emiljaregran/mecanum-wheel-rover/README.md

# mecanum-wheel-rover
A mecanum wheel rover built during a 2 week project.

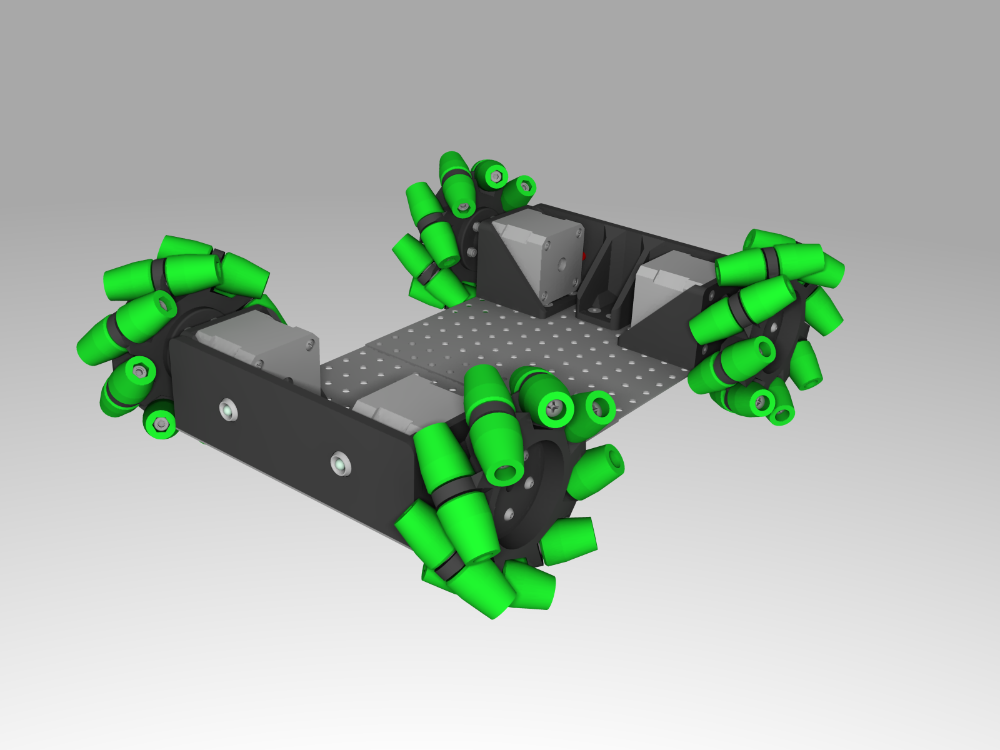
[picture p1: images/rover-front.png]
Rover front


The wheels are a remix of https://www.thingiverse.com/thing:2473
