emiljaregran/mecanum-wheel-rover/images/joystick-inside.png

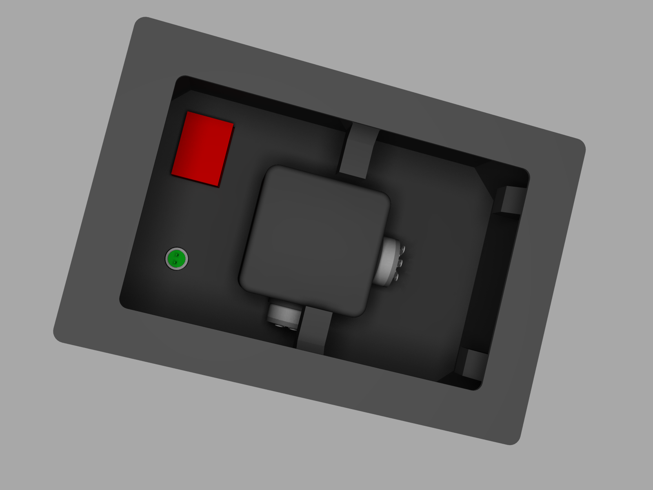
images/joystick-inside.png
