emiljaregran/mecanum-wheel-rover/images/joystick-pcb.png

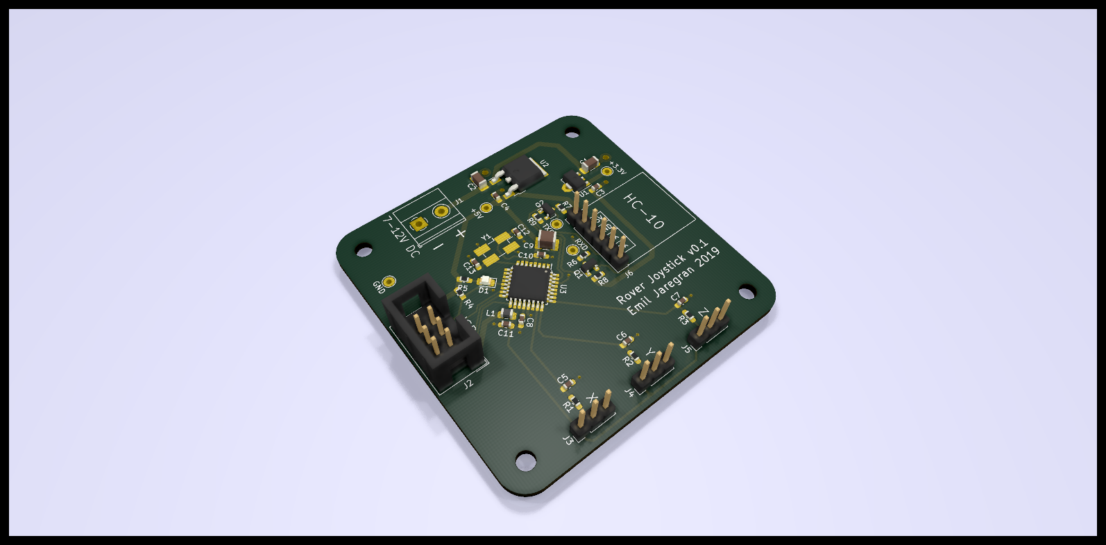
images/joystick-pcb.png
