emiljaregran/mecanum-wheel-rover/images/joystick.png

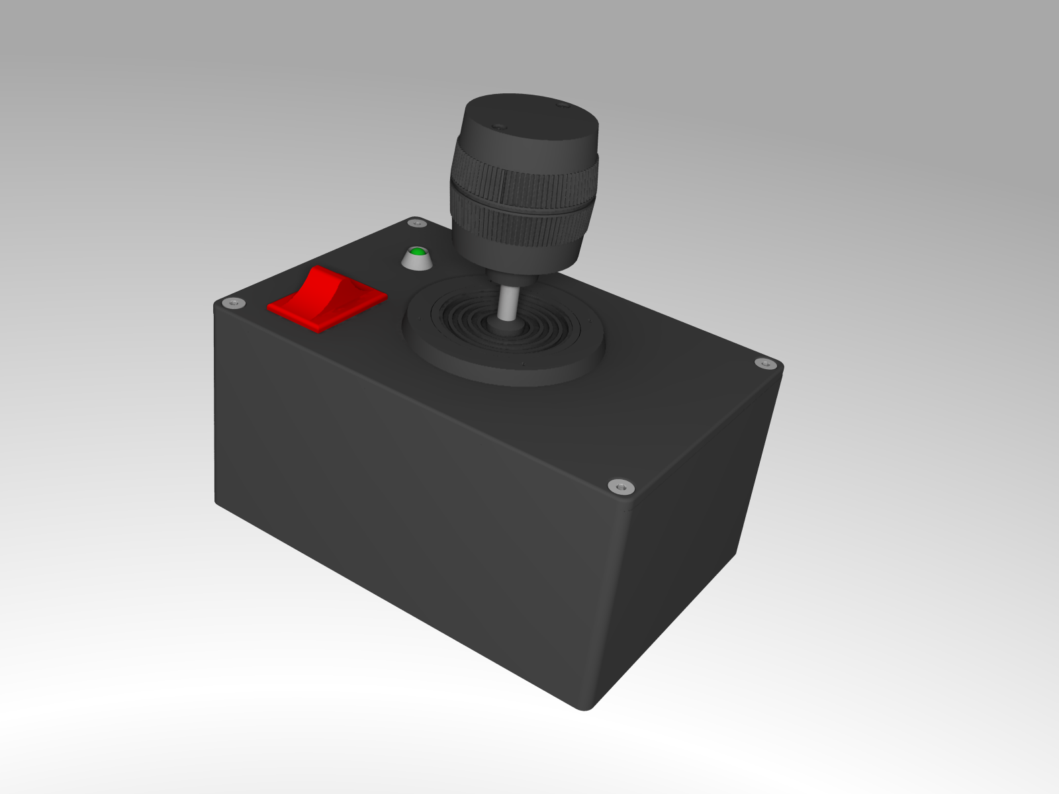
images/joystick.png
