emiljaregran/mecanum-wheel-rover/images/rover-side.png

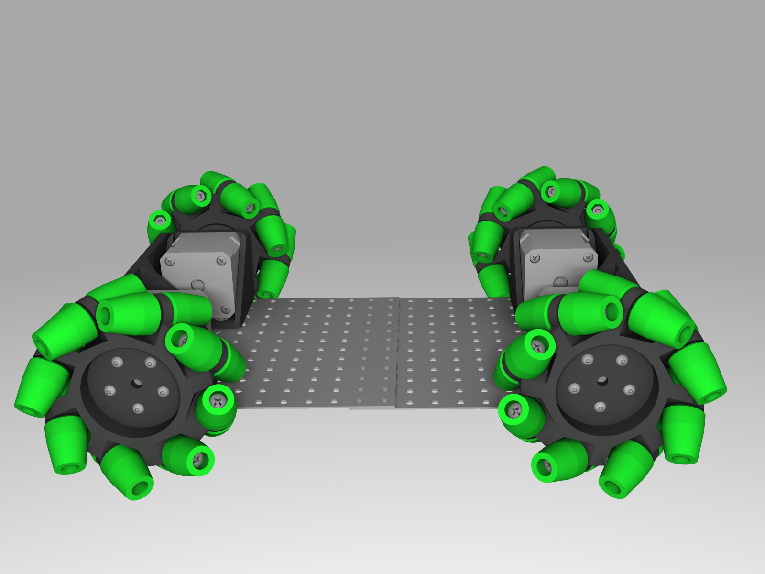
images/rover-side.png
