emiljaregran/mecanum-wheel-rover/joystick-parts/joystick_assembly.FCStd

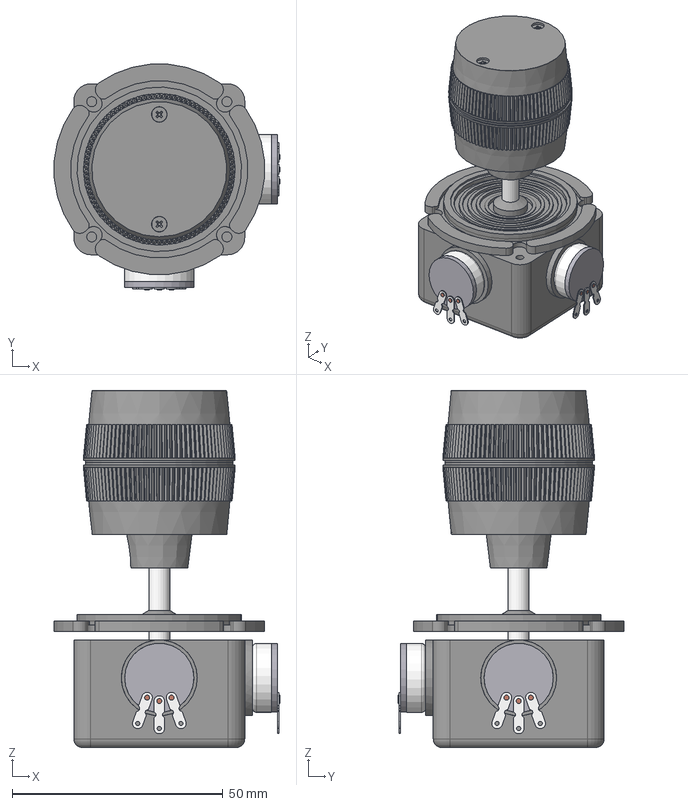
[picture p6: CAD file, 2019-10-08]
joystick-parts/joystick_assembly.FCStd
53.5 x 53.5 x 84.6 mm
joystick_base_001
joystick_shaft_001
pot_mid_001
pot_mid_002
pot_back_001
pot_back_002
pot_tab_001
pot_tab_002
pot_tab_003
pot_tab_004
pot_tab_005
pot_tab_006
pot_tab_rivet_001
pot_tab_rivet_002
pot_tab_rivet_003
pot_tab_rivet_004
pot_tab_rivet_005
pot_tab_rivet_006
joystick_knob_lower_001
joystick_knob_001
joystick_knob_002
joystick_shaft_boot_001
