emiljaregran/mecanum-wheel-rover/joystick-parts/joystick_knob_top.FCStd

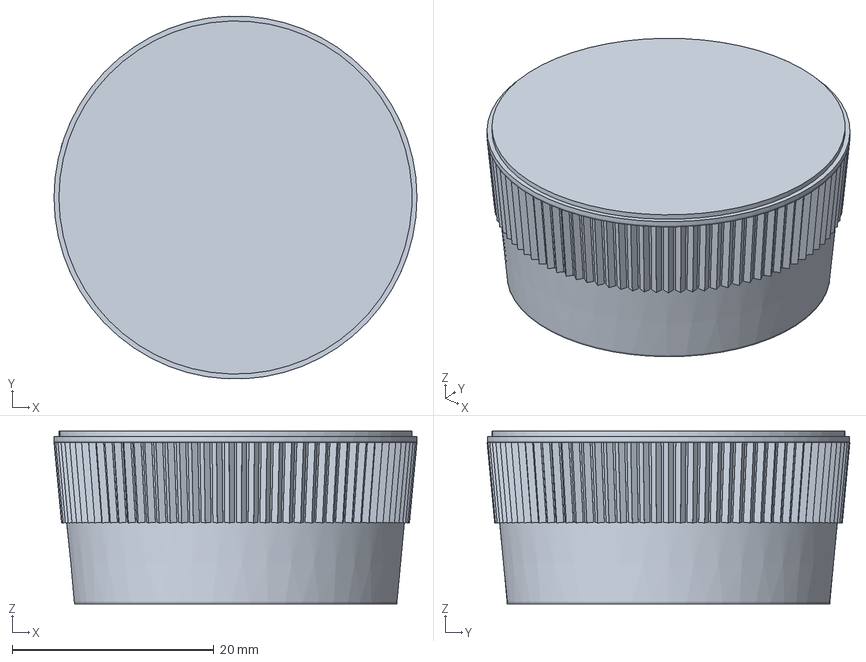
[picture p7: CAD file, 2019-10-08]
joystick-parts/joystick_knob_top.FCStd
36.0 x 36.0 x 17.1 mm
M2x4_Screw
M2x4_Screw001
