emiljaregran/mecanum-wheel-rover/rover-parts/fan_mount.FCStd

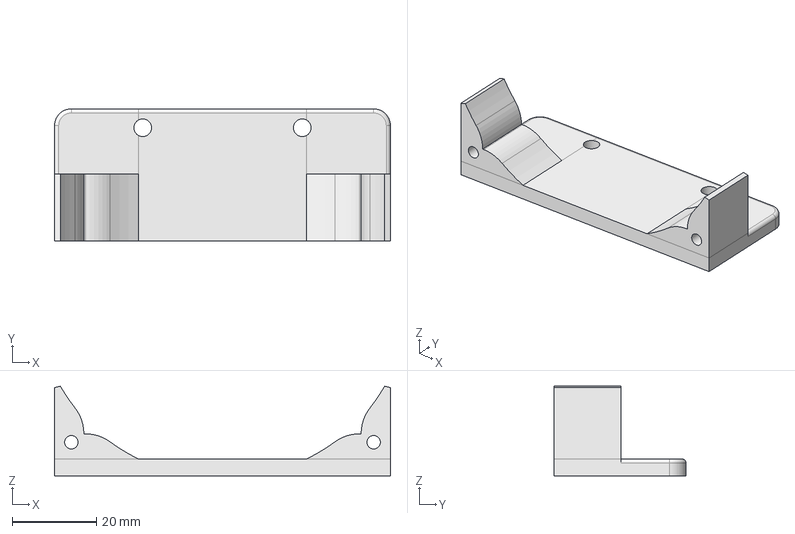
[picture p8: CAD file, 2019-10-12]
rover-parts/fan_mount.FCStd
80.0 x 31.5 x 21.3 mm
