emiljaregran/mecanum-wheel-rover/joystick-parts/pot_tab_rivet.FCStd

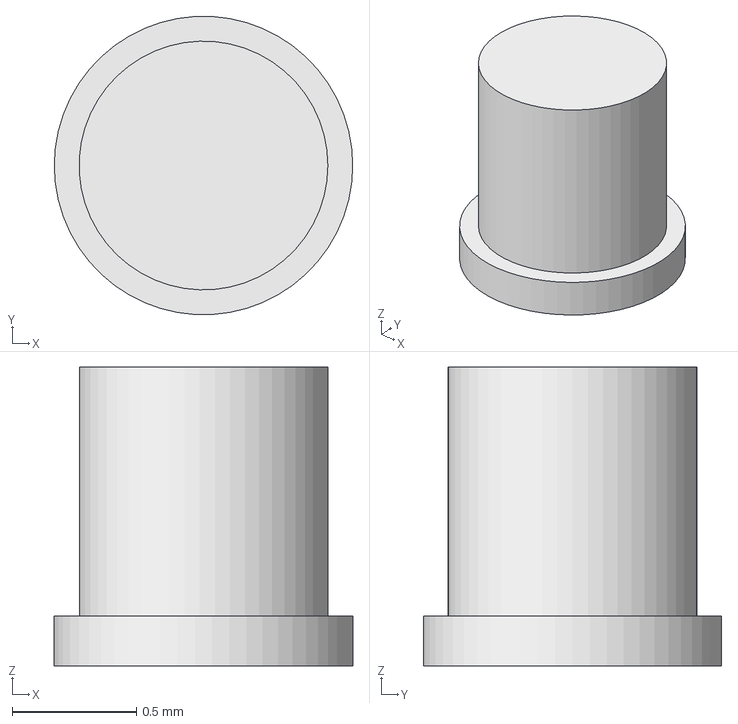
[picture p9: CAD file, 2019-10-08]
joystick-parts/pot_tab_rivet.FCStd
1.20 x 1.20 x 1.20 mm
