emiljaregran/mecanum-wheel-rover/rover-parts/stepper_motor_mount.FCStd

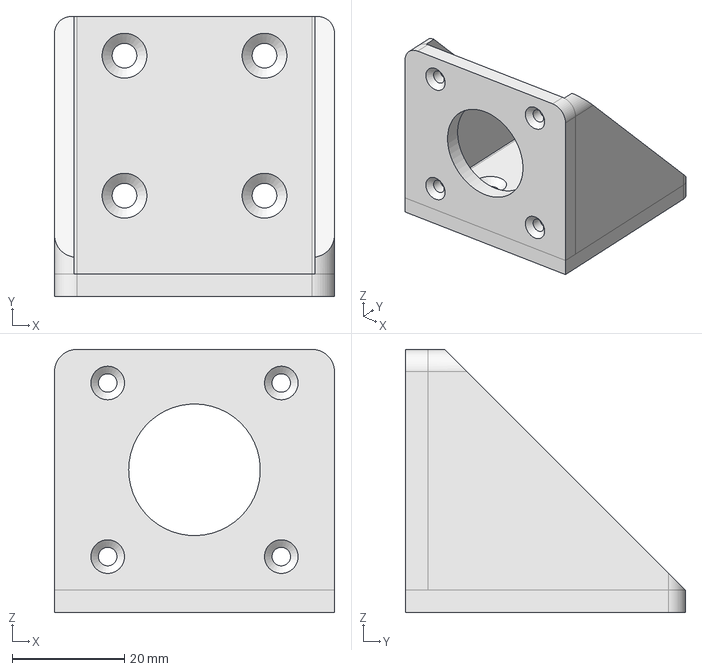
[picture p10: CAD file, 2019-10-08]
rover-parts/stepper_motor_mount.FCStd
50.0 x 50.0 x 47.0 mm
