emiljaregran/mecanum-wheel-rover/joystick-parts/pot_mid.FCStd

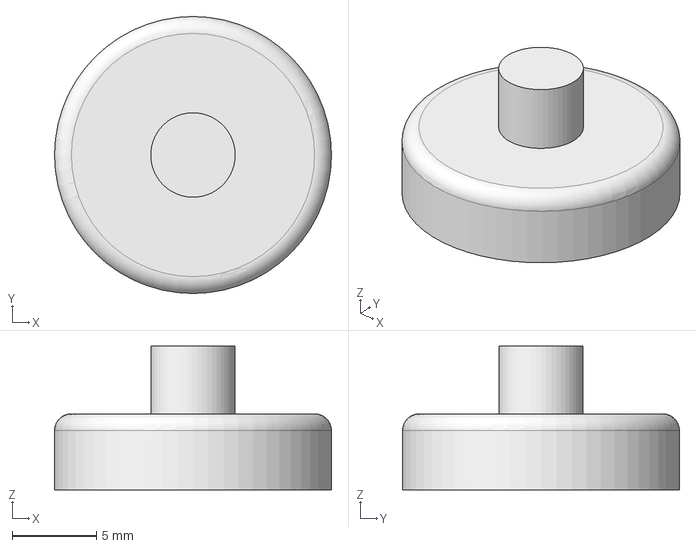
[picture p11: CAD file, 2019-10-08]
joystick-parts/pot_mid.FCStd
16.4 x 16.4 x 8.50 mm
