emiljaregran/mecanum-wheel-rover/rover-parts/stepper_motor.FCStd

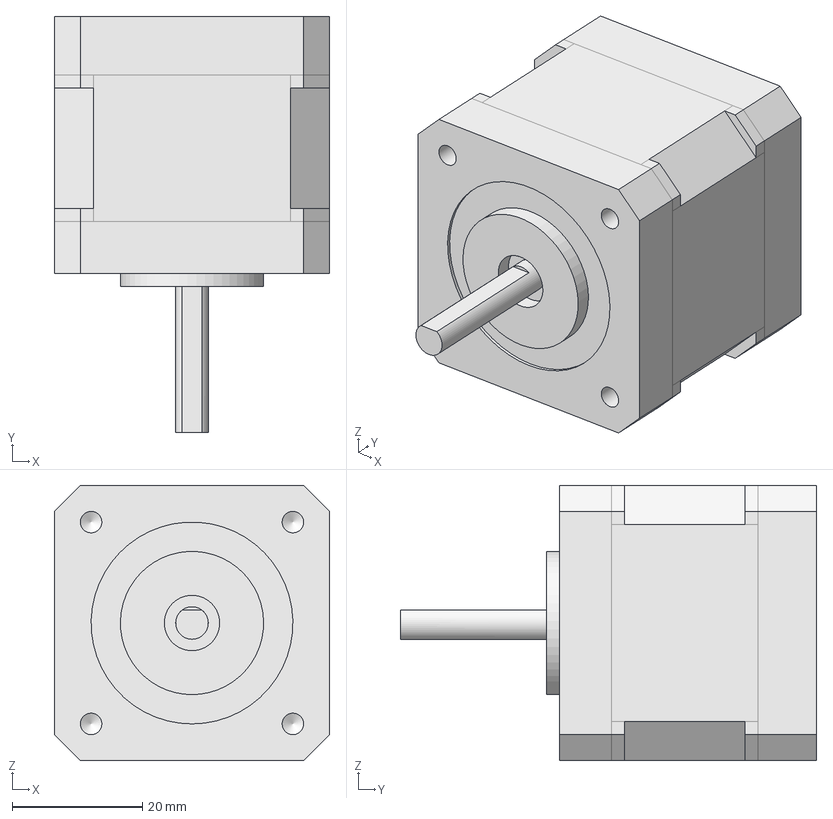
[picture p12: CAD file, 2019-10-08]
rover-parts/stepper_motor.FCStd
42.3 x 63.9 x 42.3 mm
M3x8_Screw_000
M3x8_Screw_001
M3x8_Screw_002
M3x8_Screw_003
