emiljaregran/mecanum-wheel-rover/joystick-parts/box_lid.FCStd

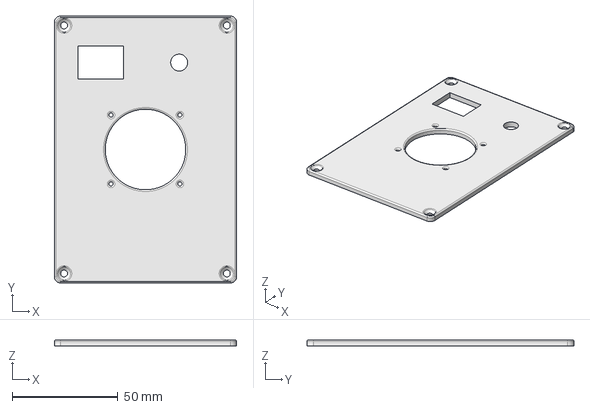
[picture p13: CAD file, 2019-10-08]
joystick-parts/box_lid.FCStd
86.0 x 126.0 x 3.00 mm
