emiljaregran/mecanum-wheel-rover/joystick-parts/joystick_knob_lower.FCStd

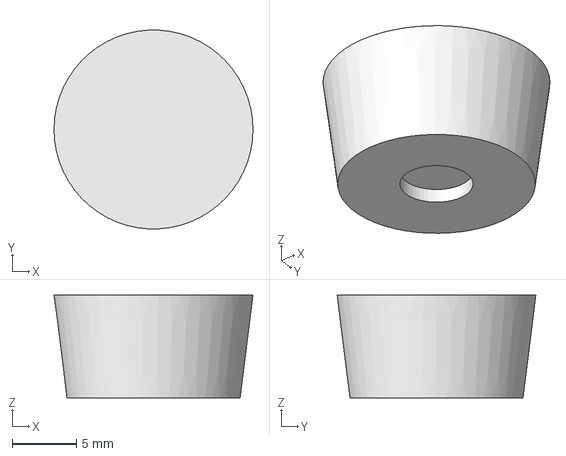
[picture p14: CAD file, 2019-10-08]
joystick-parts/joystick_knob_lower.FCStd
15.5 x 15.5 x 8.00 mm
