emiljaregran/mecanum-wheel-rover/rover-parts/wheel_right.FCStd

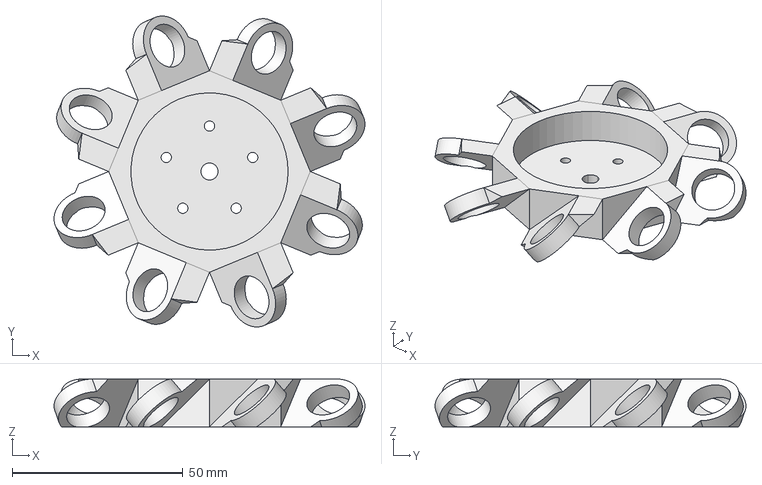
[picture p15: CAD file, 2019-10-08]
rover-parts/wheel_right.FCStd
91.0 x 91.0 x 14.0 mm
