emiljaregran/mecanum-wheel-rover/joystick-parts/joystick_mounting_ring.FCStd

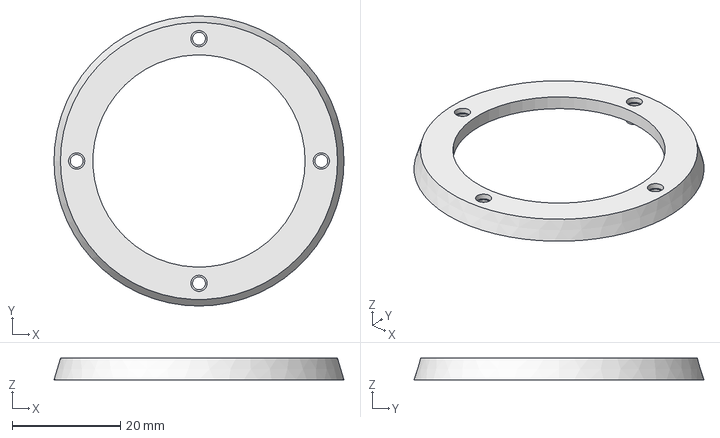
[picture p16: CAD file, 2019-10-08]
joystick-parts/joystick_mounting_ring.FCStd
53.7 x 53.7 x 4.00 mm
