emiljaregran/mecanum-wheel-rover/joystick-parts/joystick_shaft_boot.FCStd

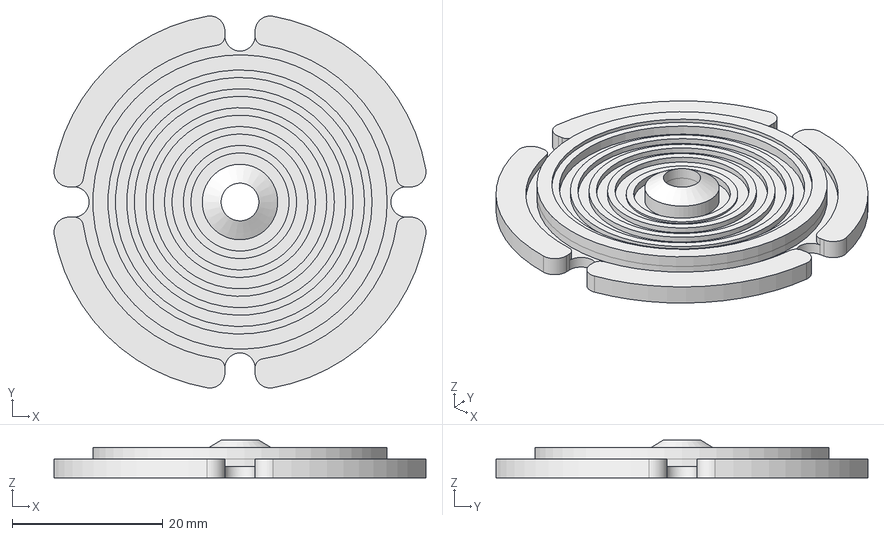
[picture p17: CAD file, 2019-10-08]
joystick-parts/joystick_shaft_boot.FCStd
49.3 x 49.3 x 5.00 mm
