emiljaregran/mecanum-wheel-rover/joystick-parts/led_holder.FCStd

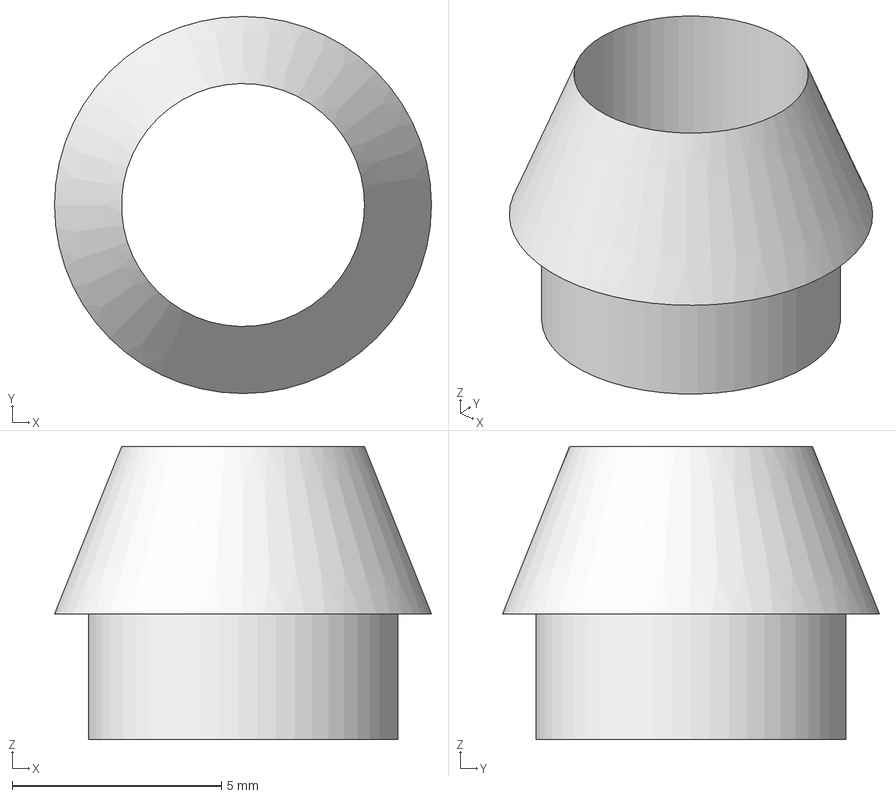
[picture p18: CAD file, 2019-10-08]
joystick-parts/led_holder.FCStd
9.00 x 9.00 x 7.00 mm
