emiljaregran/mecanum-wheel-rover/joystick-parts/joystick_knob_mid.FCStd

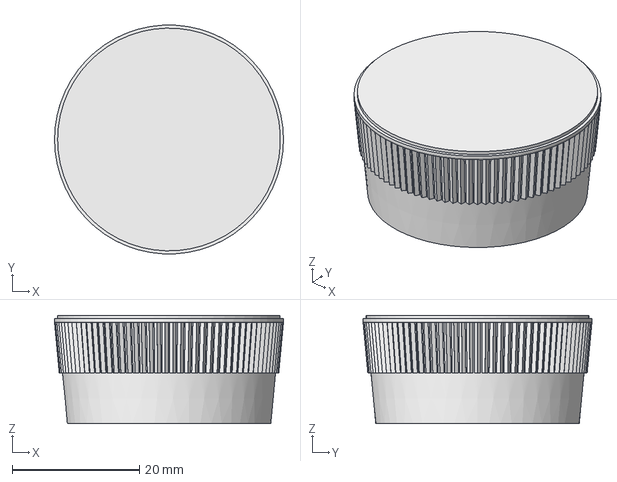
[picture p19: CAD file, 2019-10-08]
joystick-parts/joystick_knob_mid.FCStd
36.0 x 36.0 x 17.0 mm
