emiljaregran/mecanum-wheel-rover/rover-parts/led_reflector.FCStd

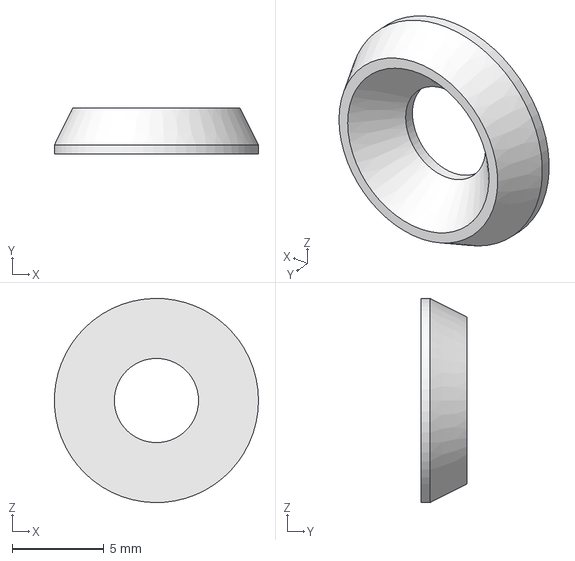
[picture p20: CAD file, 2019-10-08]
rover-parts/led_reflector.FCStd
11.1 x 2.50 x 11.1 mm
