emiljaregran/mecanum-wheel-rover/joystick-parts/pot_back.FCStd

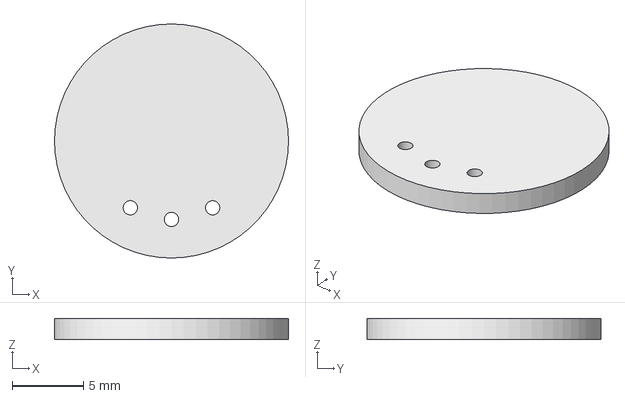
[picture p21: CAD file, 2019-10-08]
joystick-parts/pot_back.FCStd
16.4 x 16.4 x 1.50 mm
