emiljaregran/mecanum-wheel-rover/rover-parts/bearing_624.FCStd

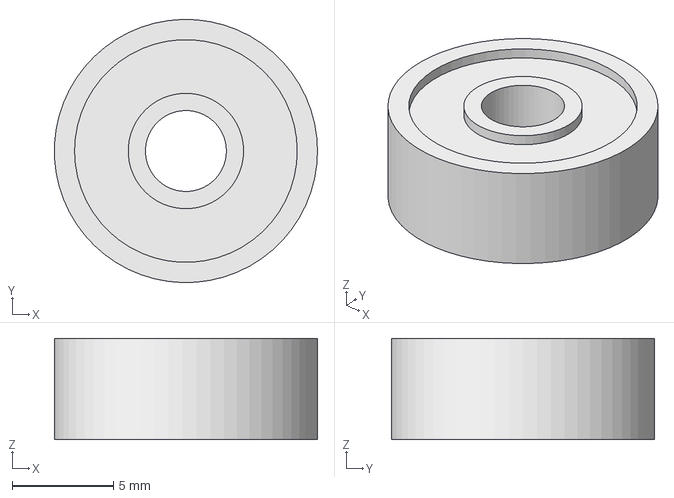
[picture p22: CAD file, 2019-10-08]
rover-parts/bearing_624.FCStd
13.0 x 13.0 x 5.00 mm
