emiljaregran/mecanum-wheel-rover/joystick-parts/pcb.FCStd

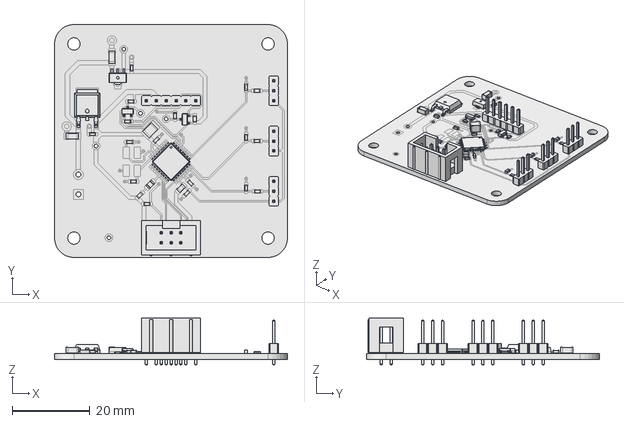
[picture p23: CAD file, 2019-10-08]
joystick-parts/pcb.FCStd
60.0 x 60.0 x 12.1 mm
