emiljaregran/mecanum-wheel-rover/rover-parts/led_5mm.FCStd

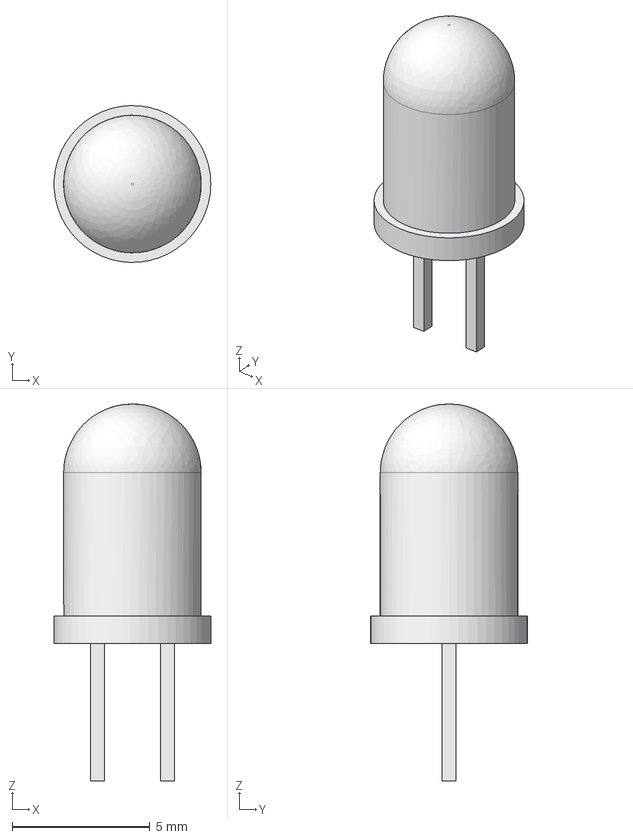
[picture p24: CAD file, 2019-10-08]
rover-parts/led_5mm.FCStd
5.69 x 5.70 x 13.7 mm
