emiljaregran/mecanum-wheel-rover/joystick-parts/joystick_shaft.FCStd

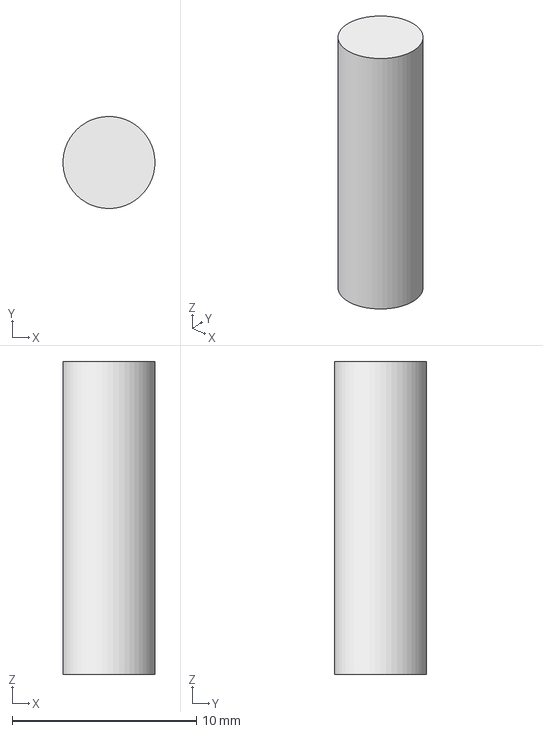
[picture p25: CAD file, 2019-10-08]
joystick-parts/joystick_shaft.FCStd
5.00 x 5.00 x 17.0 mm
