emiljaregran/mecanum-wheel-rover/joystick-parts/joystick_base.FCStd

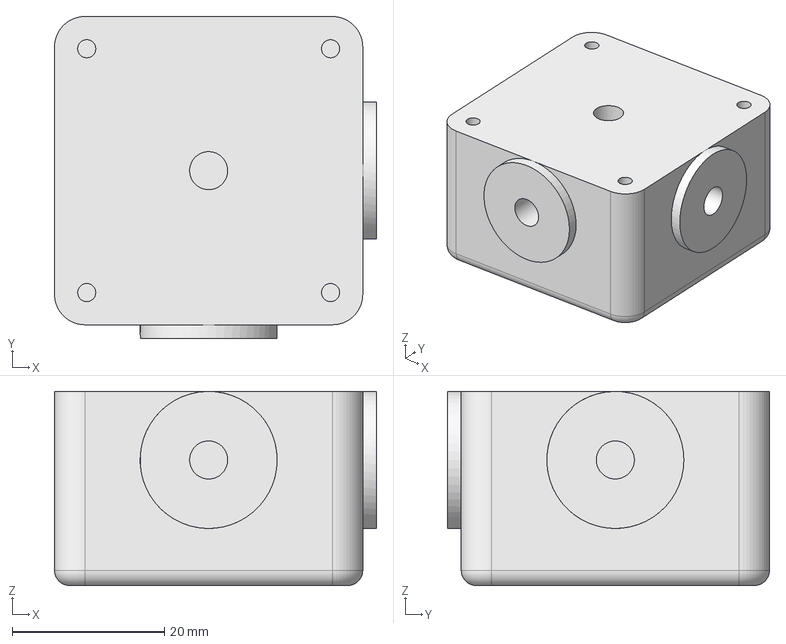
[picture p26: CAD file, 2019-10-08]
joystick-parts/joystick_base.FCStd
42.3 x 42.3 x 25.5 mm
