emiljaregran/mecanum-wheel-rover/rover-parts/bumper.FCStd

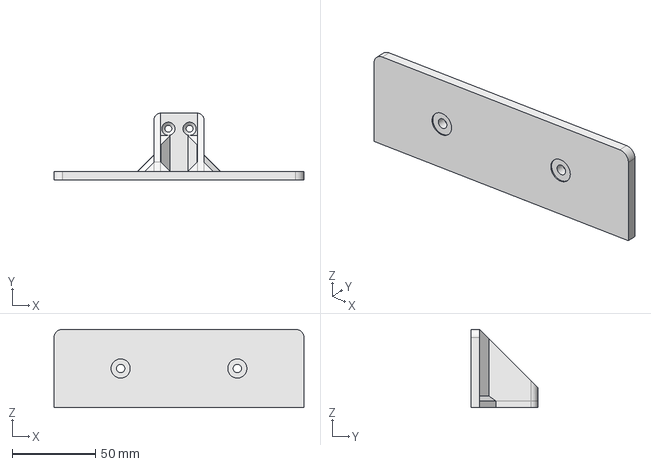
[picture p27: CAD file, 2019-10-08]
rover-parts/bumper.FCStd
150.0 x 40.0 x 47.0 mm
