emiljaregran/mecanum-wheel-rover/joystick-parts/pot_tab.FCStd

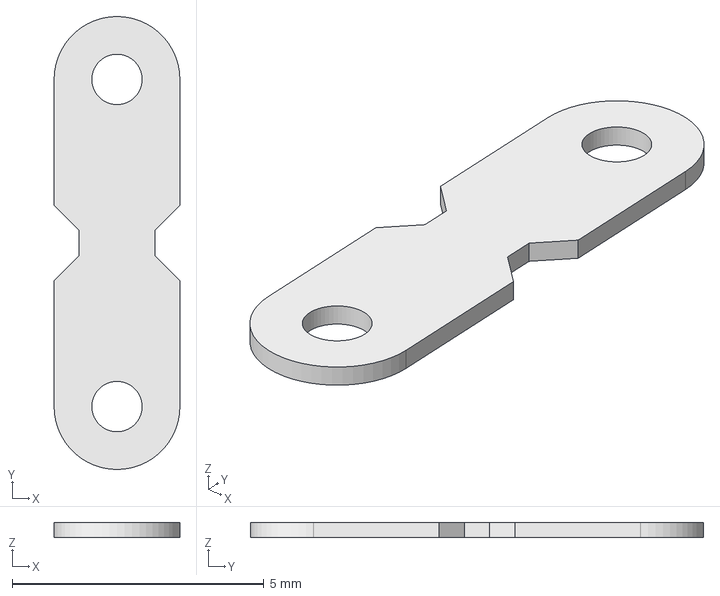
[picture p28: CAD file, 2019-10-08]
joystick-parts/pot_tab.FCStd
2.50 x 9.00 x 0.3 mm
