emiljaregran/mecanum-wheel-rover/joystick-parts/slide_switch.FCStd

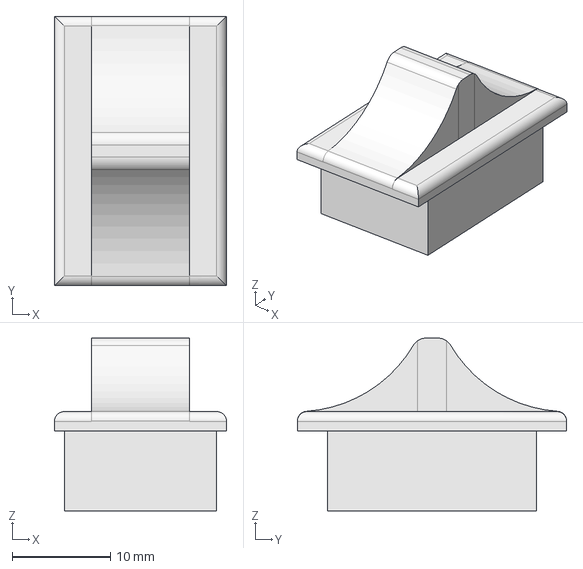
[picture p29: CAD file, 2019-10-08]
joystick-parts/slide_switch.FCStd
17.5 x 27.5 x 17.6 mm
