emiljaregran/mecanum-wheel-rover/joystick-parts/box_base.FCStd

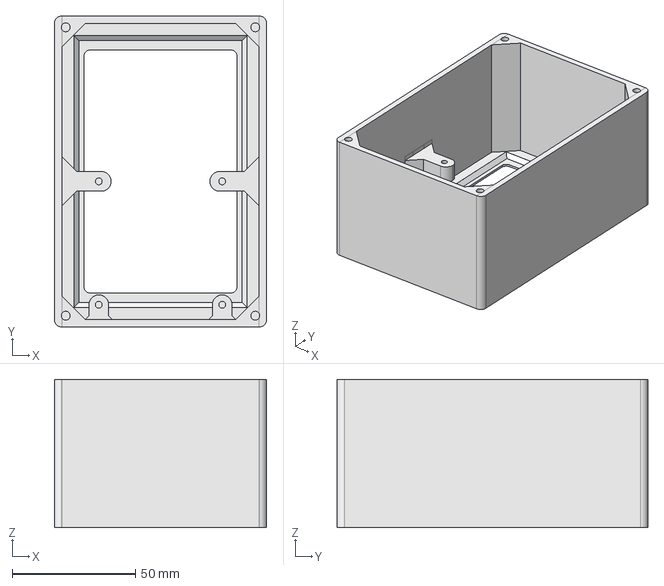
[picture p30: CAD file, 2019-10-08]
joystick-parts/box_base.FCStd
86.0 x 126.0 x 60.0 mm
