emiljaregran/mecanum-wheel-rover/rover-parts/base_plate.FCStd

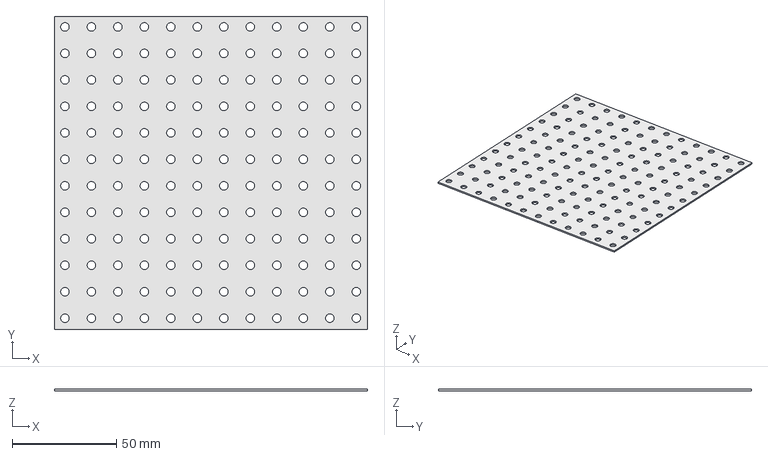
[picture p31: CAD file, 2019-10-08]
rover-parts/base_plate.FCStd
150.0 x 150.0 x 1.00 mm
