emiljaregran/mecanum-wheel-rover/rover-parts/wheel_hub.FCStd

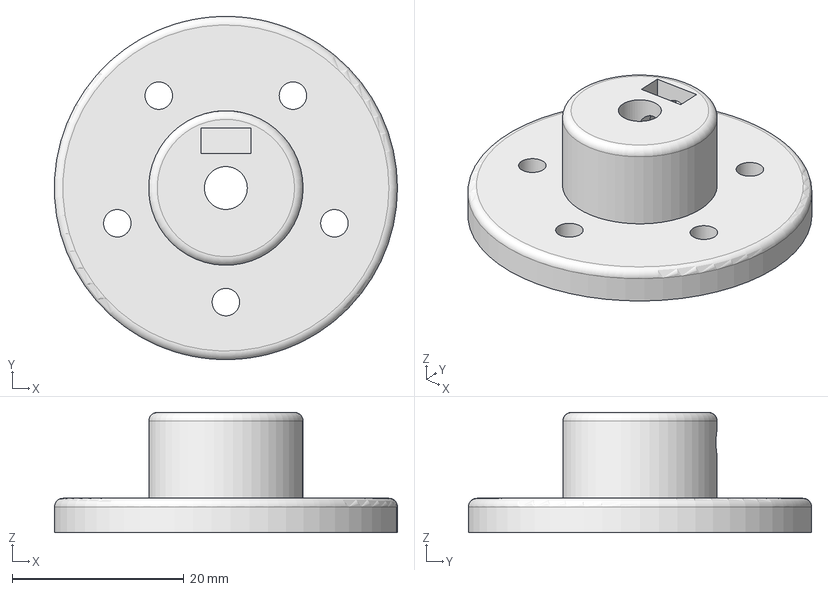
[picture p32: CAD file, 2019-10-08]
rover-parts/wheel_hub.FCStd
40.0 x 40.0 x 14.0 mm
