emiljaregran/mecanum-wheel-rover/(list of files, cad)

Other CAD files:
rover-parts/wheel_left.FCStd
joystick-parts/M2x4_Countersunk_Screw.FCStd
joystick-parts/STL/box_base.stl
joystick-parts/STL/box_lid.stl
rover-parts/M3-Nyloc-Nut.FCStd
rover-parts/M3x12-Buttonhead-Screw.FCStd
rover-parts/M3x6-Grub-Screw.FCStd
rover-parts/M3x8-Countersunk-Screw.FCStd
rover-parts/M4-Nyloc-Nut.FCStd
rover-parts/M4-Washer.FCStd
rover-parts/M4x10-Countersunk-Screw.FCStd
rover-parts/M4x12-Countersunk-Screw.FCStd
rover-parts/M4x12-Screw.FCStd
rover-parts/M4x40-Panhead-Screw.FCStd
rover-parts/STL/bumper.stl
rover-parts/STL/fan_mount.stl
rover-parts/STL/stepper_motor_mount.stl
rover-parts/STL/wheel_hub.stl
rover-parts/STL/wheel_left.stl
rover-parts/STL/wheel_right.stl
rover-parts/STL/wheel_roller_nut.stl
rover-parts/STL/wheel_roller_screw.stl
rover-parts/wheel_roller_nut.FCStd
rover-parts/wheel_roller_screw.FCStd
rover-pcb/Gerber/rover-pcb-F_SilkS.dxf
