emiljaregran/mecanum-wheel-rover/rover-pcb/rover-pcb.pdf

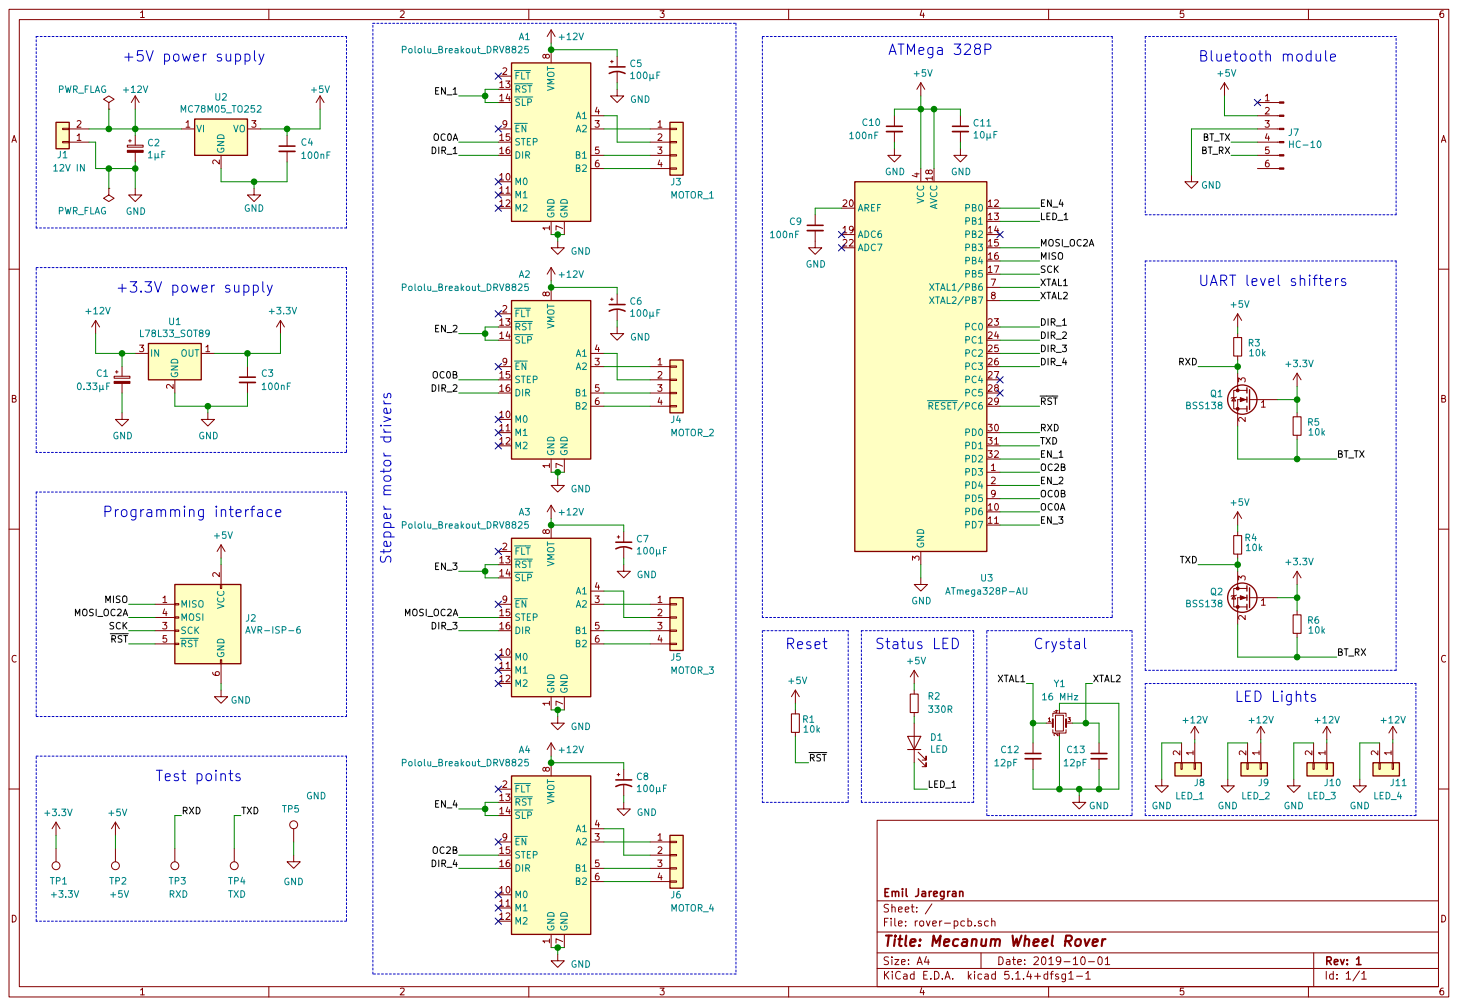
[picture p33: page 1]

1 M0 10 M1 11 M2 12 RST 13 SLP 14 STEP 15 DIR 16 FLT 2 A2 3 A1 4 B1 5 B2 6 GND

2 SCK 3 MOSI 4 RST 5 GND

File: rover-pcb.sch Sheet: / Emil Jaregran GND

Id: 1/1 Title: Mecanum Wheel Rover
