emiljaregran/mecanum-wheel-rover/joystick-pcb/joystick-pcb.pdf

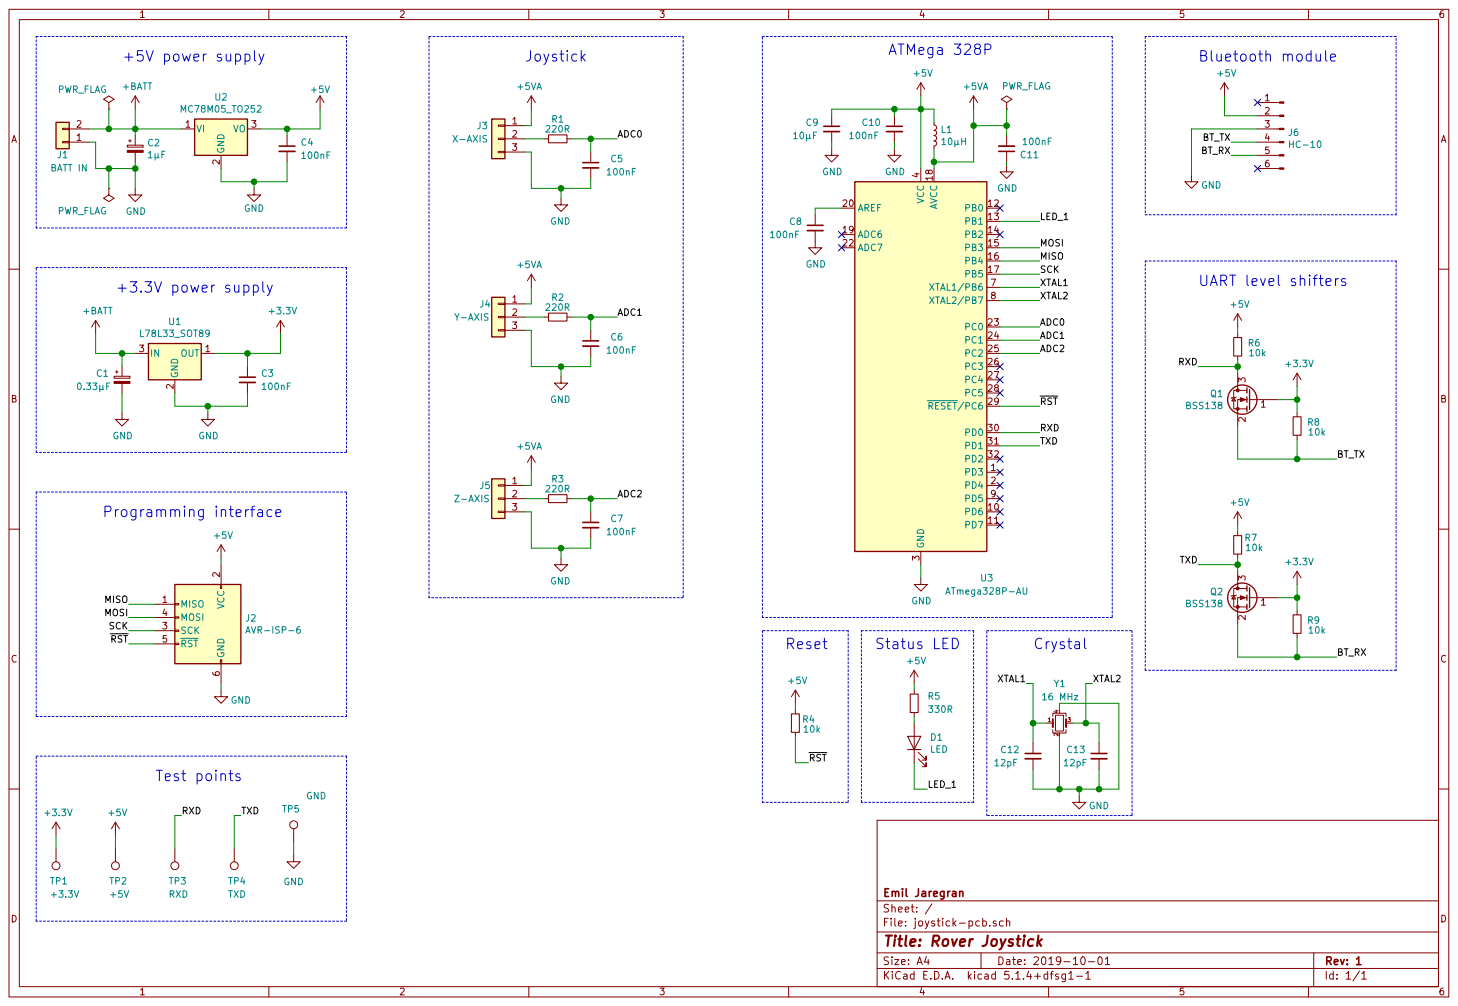
[picture p34: page 1]

Id: 1/1 Title: Rover Joystick
