emiljaregran/mecanum-wheel-rover/joystick-pcb/joystick-pcb.kicad_pcb

## KiCad design joystick-pcb/joystick-pcb.kicad_pcb (2019-10-08)

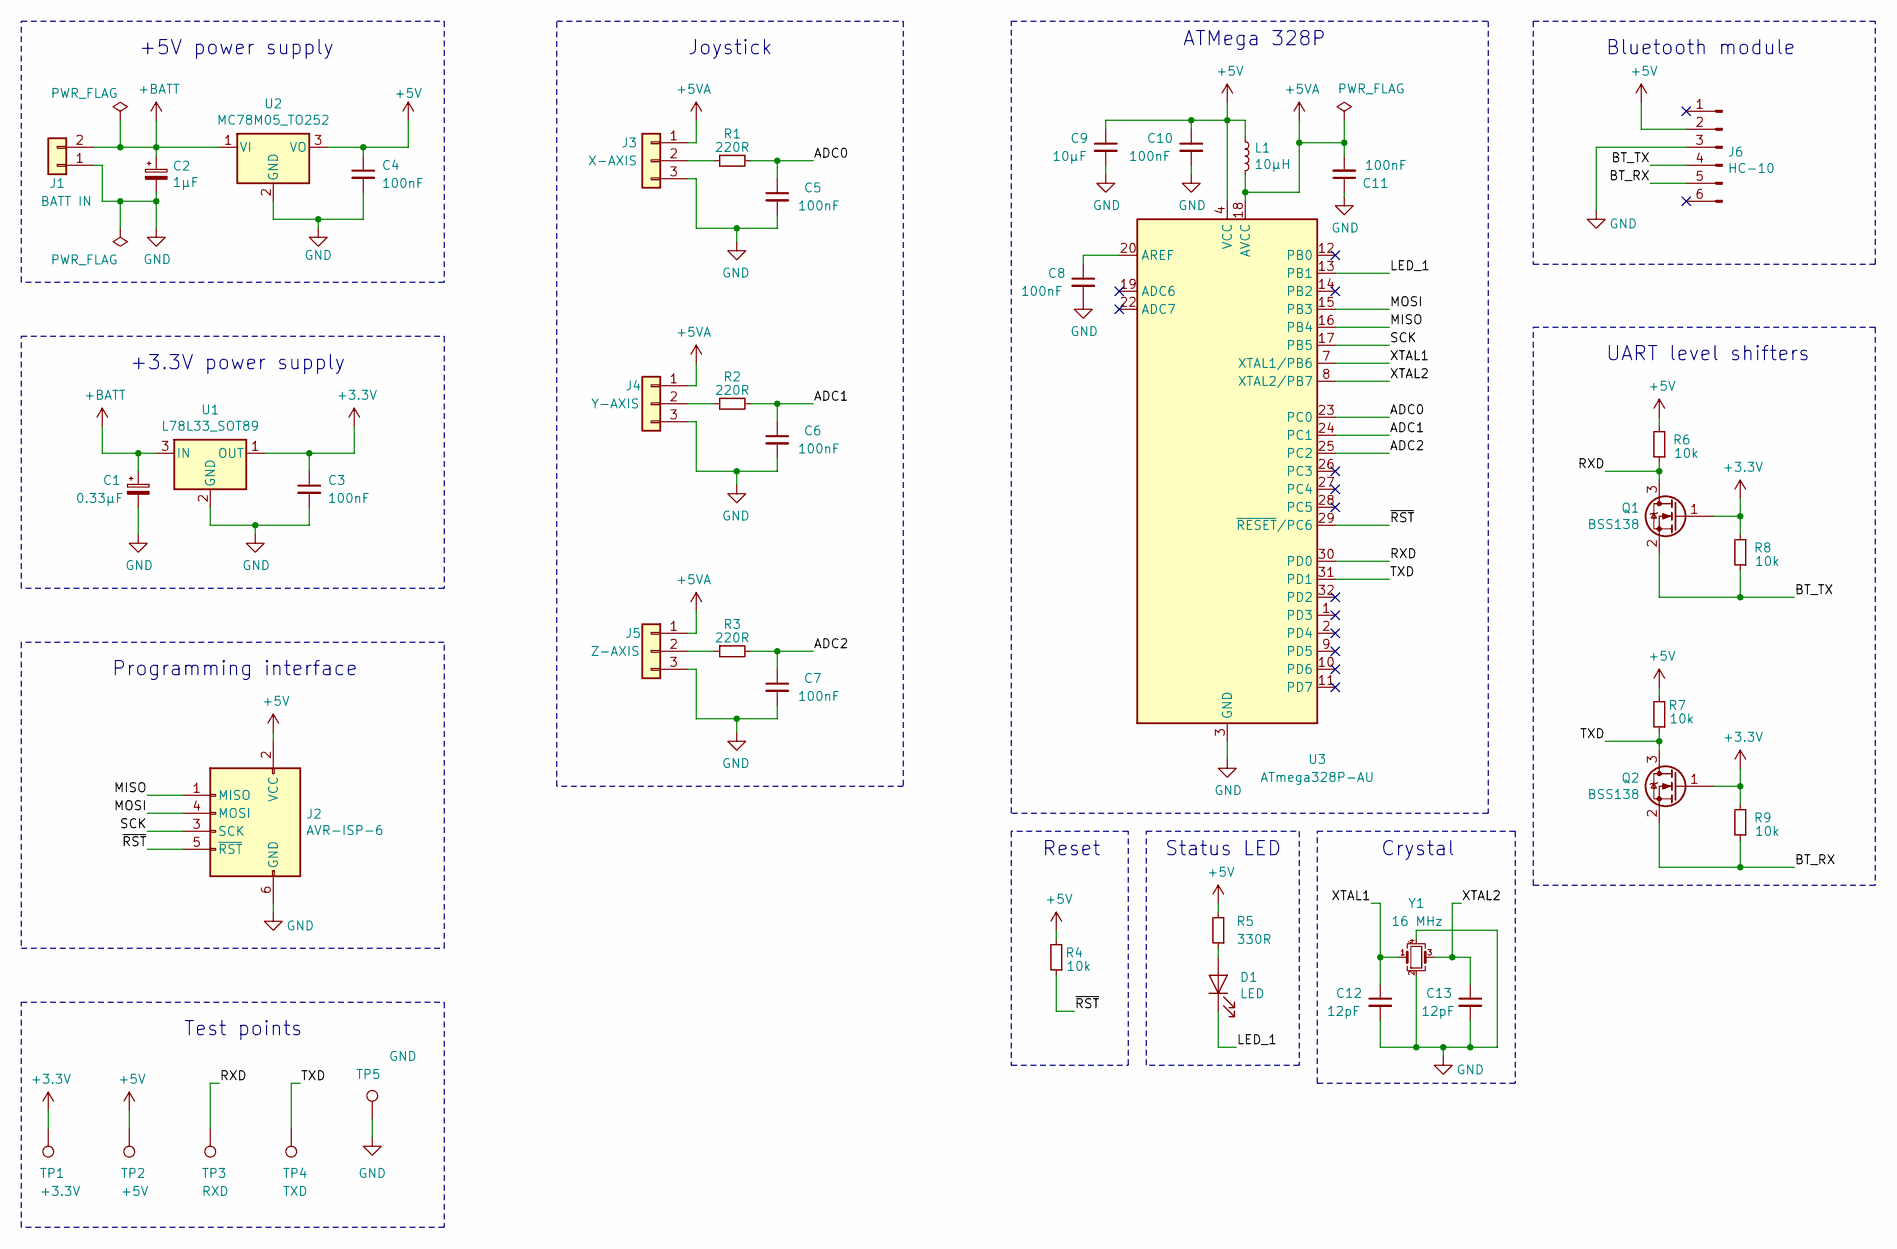
[picture p35: schematic joystick-pcb.sch, Rover Joystick]

Parts:
C1: 0.33μF; C_1206_3216Metric_Pad1.42x1.75mm_HandSolder
C2: 1μF; C_1206_3216Metric_Pad1.42x1.75mm_HandSolder
C3, C4, C5, C6, C7, C8, C10, C11: 100nF; C_0603_1608Metric_Pad1.05x0.95mm_HandSolder
C9: 10μF; C_1210_3225Metric_Pad1.42x2.65mm_HandSolder
C12, C13: 12pF; C_0603_1608Metric_Pad1.05x0.95mm_HandSolder
D1: LED; LED_0805_2012Metric_Pad1.15x1.40mm_HandSolder
J1: BATT IN; TerminalBlock_Phoenix_MKDS-1,5-2-5.08_1x02_P5.08mm_Horizont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
J2: AVR-ISP-6; IDC-Header_2x03_P2.54mm_Vertical
J3: X-AXIS; PinHeader_1x03_P2.54mm_Vertical
J4: Y-AXIS; PinHeader_1x03_P2.54mm_Vertical
J5: Z-AXIS; PinHeader_1x03_P2.54mm_Vertical
J6: HC-10; PinHeader_1x06_P2.54mm_Vertical
L1: 10μH; L_0805_2012Metric_Pad1.15x1.40mm_HandSolder
Q1, Q2: BSS138; SOT-23
R1, R2, R3: 220R; R_0603_1608Metric_Pad1.05x0.95mm_HandSolder
R4, R6, R7, R8, R9: 10k; R_0603_1608Metric_Pad1.05x0.95mm_HandSolder
R5: 330R; R_0603_1608Metric_Pad1.05x0.95mm_HandSolder
TP1: +3.3V; TestPoint_THTPad_D2.0mm_Drill1.0mm
TP2: +5V; TestPoint_THTPad_D2.0mm_Drill1.0mm
TP3: RXD; TestPoint_THTPad_D2.0mm_Drill1.0mm
TP4: TXD; TestPoint_THTPad_D2.0mm_Drill1.0mm
TP5: GND; TestPoint_THTPad_D2.0mm_Drill1.0mm
U1: L78L33_SOT89; SOT-89-3
U2: MC78M05_TO252; TO-252-2
U3: ATmega328P-AU; TQFP-32_7x7mm_P0.8mm
Y1: 16 MHz; Crystal_SMD_EuroQuartz_MJ-4Pin_5.0x3.2mm_HandSoldering

Connections:
+3V3: C3.1, Q1.1 (G), Q2.1 (G), R8.2, R9.2, TP1.1, U1.1 (OUT)
+5V: C4.1, C9.1, C10.1, J2.2 (VCC), J6.2, L1.1, R4.2, R5.2, R6.2, R7.2, TP2.1, U2.3 (VO), U3.4 (VCC), U3.6 (VCC)
+5VA: C11.2, J3.1, J4.1, J5.1, L1.2, U3.18 (AVCC)
+BATT: C1.1, C2.1, J1.2, U1.3 (IN), U2.1 (VI)
/ADC0: C5.1, R1.2, U3.23 (PC0)
/ADC1: C6.1, R2.2, U3.24 (PC1)
/ADC2: C7.1, R3.2, U3.25 (PC2)
/BT_RX: J6.5, Q2.2 (S), R9.1
/BT_TX: J6.4, Q1.2 (S), R8.1
/LED_1: D1.1 (K), U3.13 (PB1)
/MISO: J2.1 (MISO), U3.16 (PB4)
/MOSI: J2.4 (MOSI), U3.15 (PB3)
/RXD: Q1.3 (D), R6.1, TP3.1, U3.30 (PD0)
/SCK: J2.3 (SCK), U3.17 (PB5)
/TXD: Q2.3 (D), R7.1, TP4.1, U3.31 (PD1)
/XTAL1: C12.1, U3.7 (XTAL1/PB6), Y1.1
/XTAL2: C13.1, U3.8 (XTAL2/PB7), Y1.3
/~RST: J2.5 (~RST), R4.1, U3.29 (~RESET~/PC6)
GND: C1.2, C2.2, C3.2, C4.2, C5.2, C6.2, C7.2, C8.2, C9.2, C10.2, C11.1, C12.2, C13.2, J1.1, J2.6 (GND), J3.3, J4.3, J5.3, J6.3, TP5.1, U1.2 (GND), U2.2 (GND), U3.3 (GND), U3.5 (GND), U3.21 (GND), Y1.2, Y1.4
unnamed: C8.1, U3.20 (AREF)
unnamed: D1.2 (A), R5.1
unnamed: J3.2, R1.1
unnamed: J4.2, R2.1
unnamed: J5.2, R3.1

Notes on the sheet:
UART level shifters
Bluetooth module
+5V power supply
+3.3V power supply
Programming interface
Test points
Crystal
ATMega 328P
Status LED
Reset
Joystick

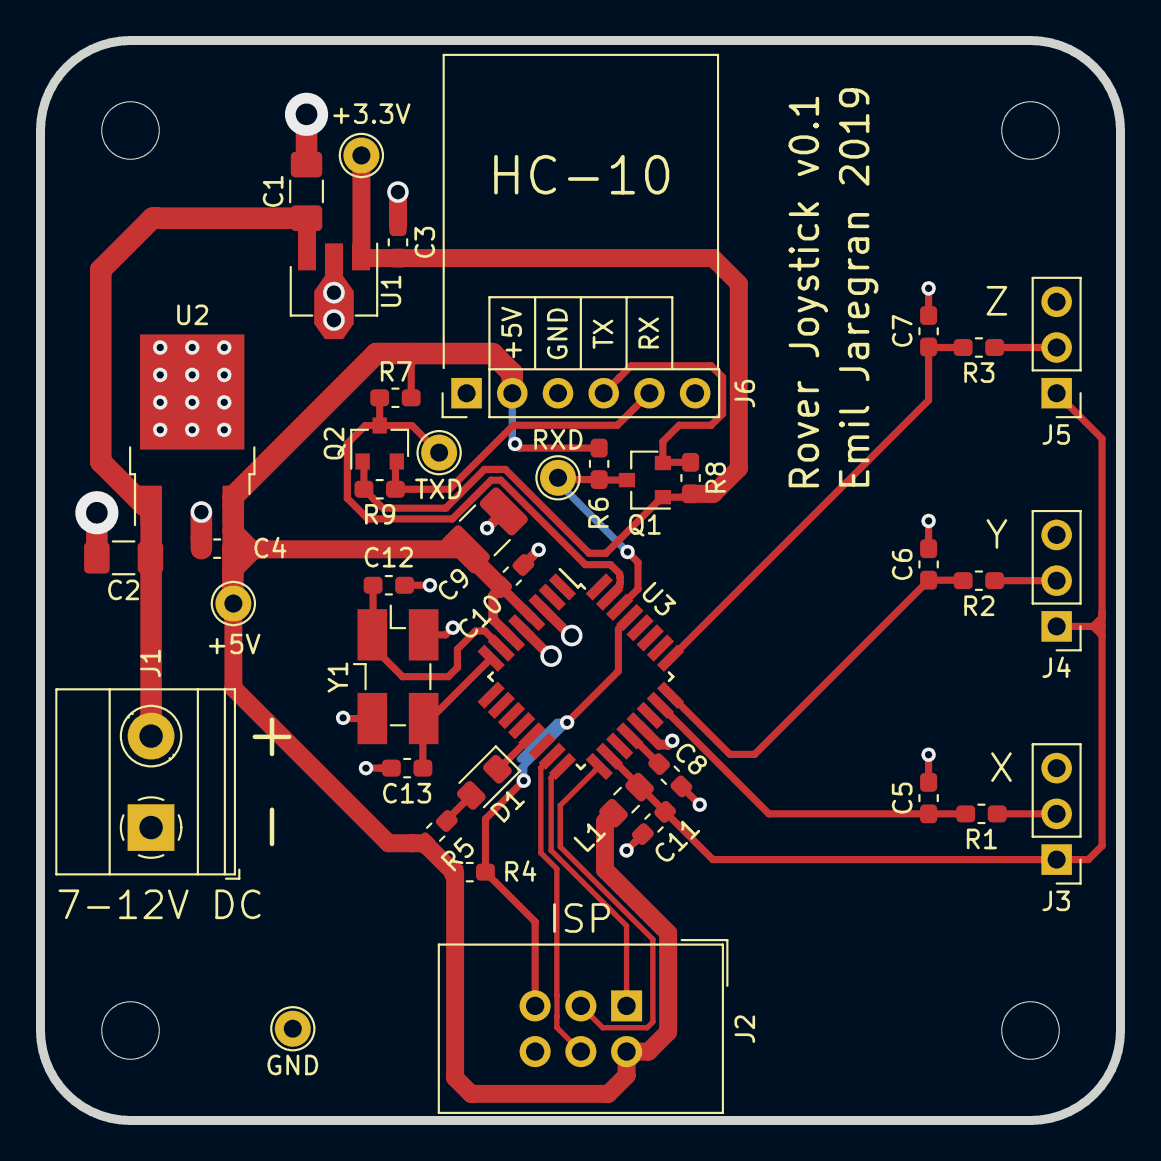
[picture p36: board joystick-pcb.kicad_pcb from above]

Board: 2 copper layers, 60.0 x 60.0 mm, 41 parts (0 on the bottom side), 24 nets.
