emiljaregran/mecanum-wheel-rover/rover-pcb/rover-pcb.kicad_pcb

## KiCad design rover-pcb/rover-pcb.kicad_pcb (2019-10-08)

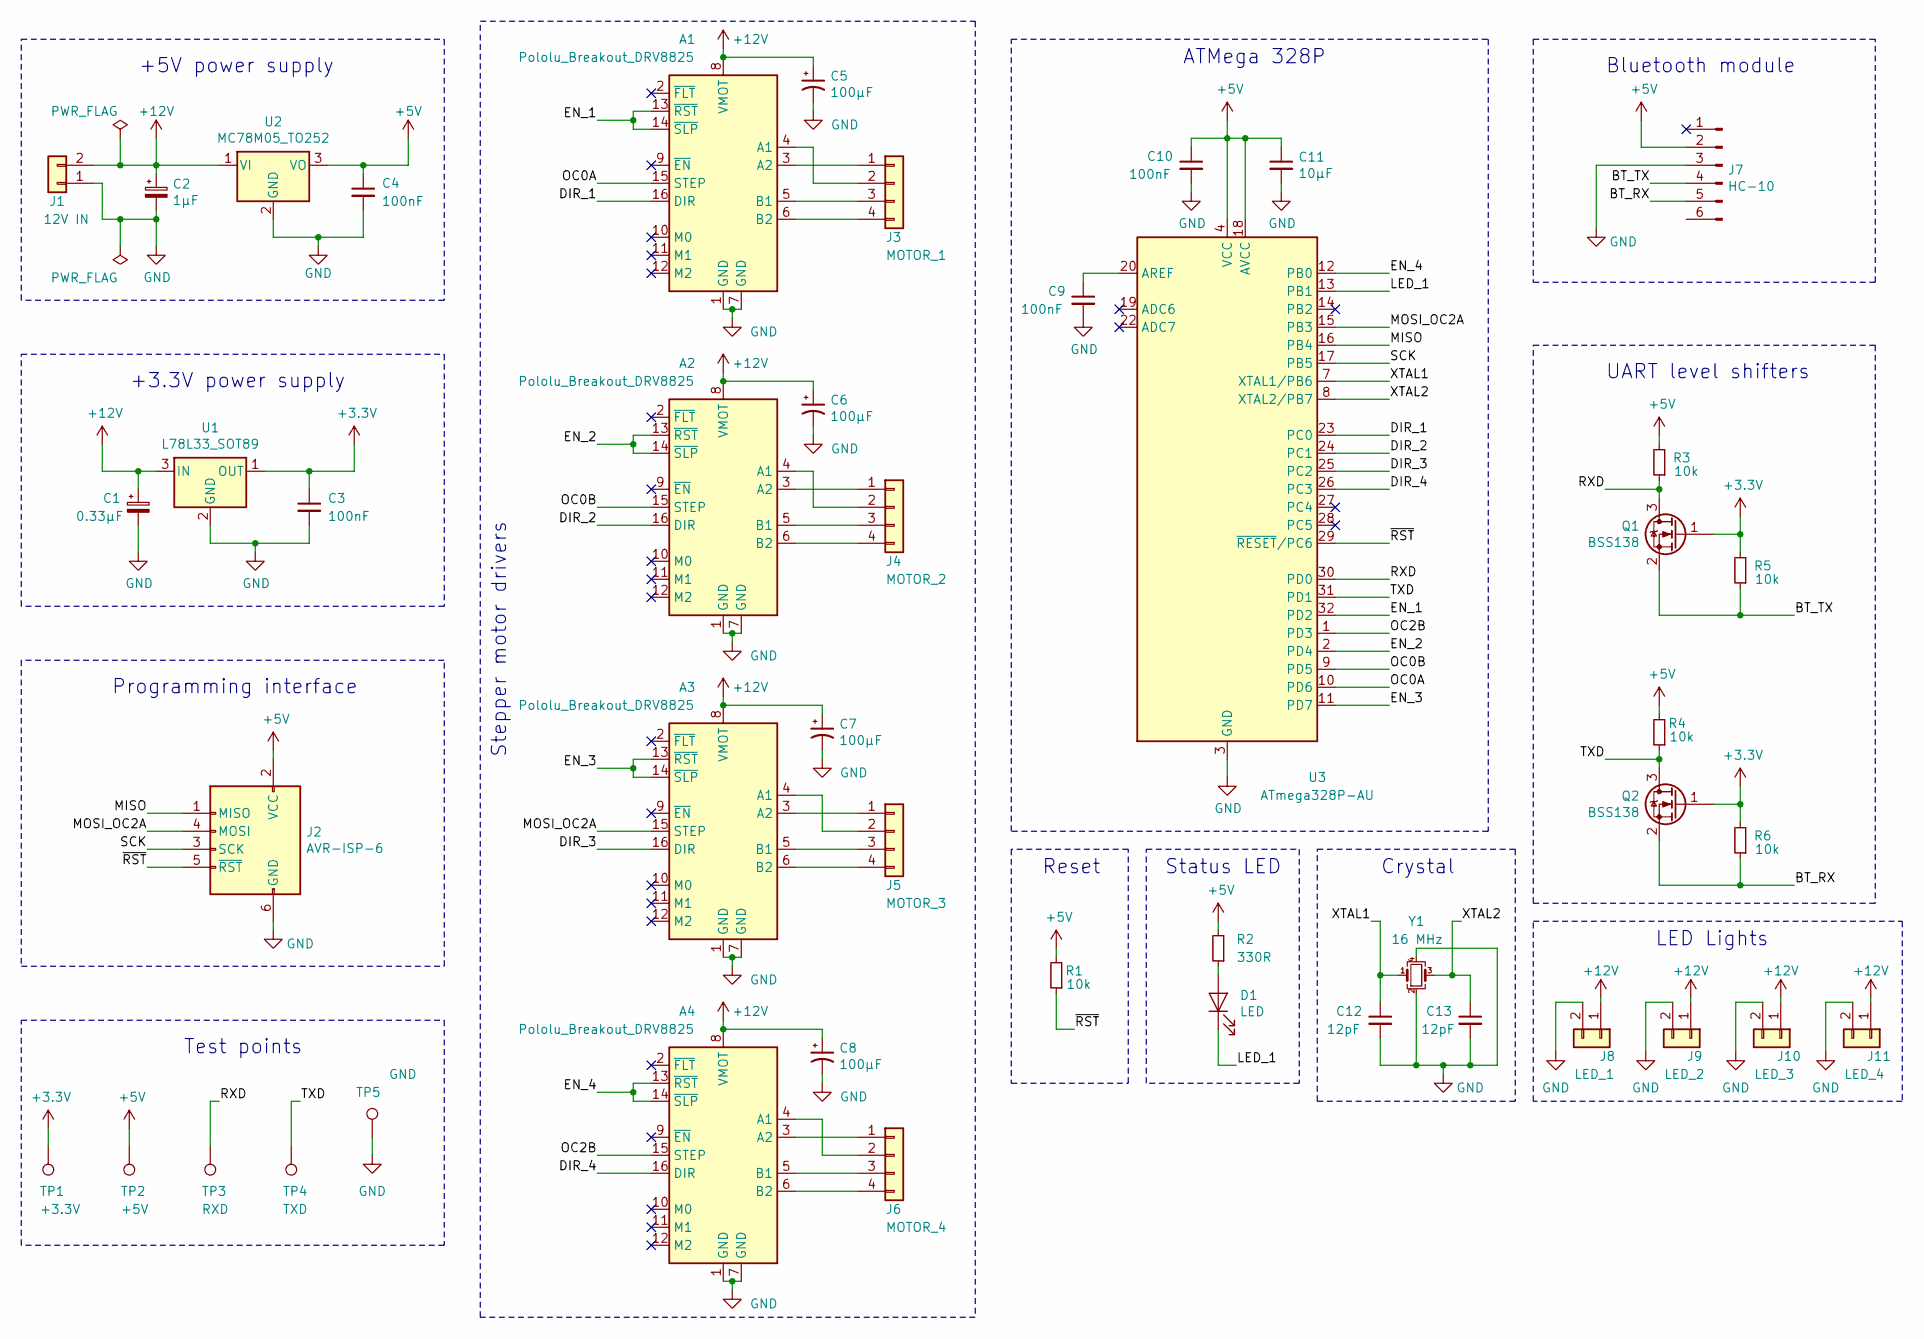
[picture p37: schematic rover-pcb.sch, Mecanum Wheel Rover]

Parts:
A1, A2, A3, A4: Pololu_Breakout_DRV8825; Pololu_Breakout-16_15.2x20.3mm
C1: 0.33μF; C_1206_3216Metric_Pad1.42x1.75mm_HandSolder
C2: 1μF; C_1206_3216Metric_Pad1.42x1.75mm_HandSolder
C3, C4, C9, C10: 100nF; C_0603_1608Metric_Pad1.05x0.95mm_HandSolder
C5, C6, C7, C8: 100μF; CP_Elec_6.3x7.7
C11: 10μF; C_1210_3225Metric_Pad1.42x2.65mm_HandSolder
C12, C13: 12pF; C_0603_1608Metric_Pad1.05x0.95mm_HandSolder
D1: LED; LED_0805_2012Metric_Pad1.15x1.40mm_HandSolder
J1: 12V IN; TerminalBlock_Phoenix_MKDS-1,5-2-5.08_1x02_P5.08mm_Horizont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
J2: AVR-ISP-6; IDC-Header_2x03_P2.54mm_Vertical
J3: MOTOR_1; PinHeader_1x04_P2.54mm_Vertical
J4: MOTOR_2; PinHeader_1x04_P2.54mm_Vertical
J5: MOTOR_3; PinHeader_1x04_P2.54mm_Vertical
J6: MOTOR_4; PinHeader_1x04_P2.54mm_Vertical
J7: HC-10; PinHeader_1x06_P2.54mm_Vertical
J8: LED_1; SolderWirePad_1x02_SMD_2x4mm
J9: LED_2; SolderWirePad_1x02_SMD_2x4mm
J10: LED_3; SolderWirePad_1x02_SMD_2x4mm
J11: LED_4; SolderWirePad_1x02_SMD_2x4mm
Q1, Q2: BSS138; SOT-23
R1, R3, R4, R5, R6: 10k; R_0603_1608Metric_Pad1.05x0.95mm_HandSolder
R2: 330R; R_0603_1608Metric_Pad1.05x0.95mm_HandSolder
TP1: +3.3V; TestPoint_THTPad_D2.0mm_Drill1.0mm
TP2: +5V; TestPoint_THTPad_D2.0mm_Drill1.0mm
TP3: RXD; TestPoint_THTPad_D2.0mm_Drill1.0mm
TP4: TXD; TestPoint_THTPad_D2.0mm_Drill1.0mm
TP5: GND; TestPoint_THTPad_D2.0mm_Drill1.0mm
U1: L78L33_SOT89; SOT-89-3
U2: MC78M05_TO252; TO-252-2
U3: ATmega328P-AU; TQFP-32_7x7mm_P0.8mm
Y1: 16 MHz; Crystal_SMD_EuroQuartz_MJ-4Pin_5.0x3.2mm_HandSoldering

Connections:
+3V3: C3.1, Q1.1 (G), Q2.1 (G), R5.2, R6.2, TP1.1, U1.1 (OUT)
+5V: C4.1, C10.1, C11.1, J2.2 (VCC), J7.2, R1.2, R2.2, R3.2, R4.2, TP2.1, U2.3 (VO), U3.4 (VCC), U3.6 (VCC), U3.18 (AVCC)
+12V: A1.8 (VMOT), A2.8 (VMOT), A3.8 (VMOT), A4.8 (VMOT), C1.1, C2.1, C5.1, C6.1, C7.1, C8.1, J1.2, J8.1, J9.1, J10.1, J11.1, U1.3 (IN), U2.1 (VI)
/BT_RX: J7.5, Q2.2 (S), R6.1
/BT_TX: J7.4, Q1.2 (S), R5.1
/DIR_1: A1.16 (DIR), U3.23 (PC0)
/DIR_2: A2.16 (DIR), U3.24 (PC1)
/DIR_3: A3.16 (DIR), U3.25 (PC2)
/DIR_4: A4.16 (DIR), U3.26 (PC3)
/EN_1: A1.13 (~RST), A1.14 (~SLP), U3.32 (PD2)
/EN_2: A2.13 (~RST), A2.14 (~SLP), U3.2 (PD4)
/EN_3: A3.13 (~RST), A3.14 (~SLP), U3.11 (PD7)
/EN_4: A4.13 (~RST), A4.14 (~SLP), U3.12 (PB0)
/LED_1: D1.1 (K), U3.13 (PB1)
/MISO: J2.1 (MISO), U3.16 (PB4)
/MOSI_OC2A: A3.15 (STEP), J2.4 (MOSI), U3.15 (PB3)
/OC0A: A1.15 (STEP), U3.10 (PD6)
/OC0B: A2.15 (STEP), U3.9 (PD5)
/OC2B: A4.15 (STEP), U3.1 (PD3)
/RXD: Q1.3 (D), R3.1, TP3.1, U3.30 (PD0)
/SCK: J2.3 (SCK), U3.17 (PB5)
/TXD: Q2.3 (D), R4.1, TP4.1, U3.31 (PD1)
/XTAL1: C12.1, U3.7 (XTAL1/PB6), Y1.1
/XTAL2: C13.1, U3.8 (XTAL2/PB7), Y1.3
/~RST: J2.5 (~RST), R1.1, U3.29 (~RESET~/PC6)
GND: A1.1 (GND), A1.7 (GND), A2.1 (GND), A2.7 (GND), A3.1 (GND), A3.7 (GND), A4.1 (GND), A4.7 (GND), C1.2, C2.2, C3.2, C4.2, C5.2, C6.2, C7.2, C8.2, C9.2, C10.2, C11.2, C12.2, C13.2, J1.1, J2.6 (GND), J7.3, J8.2, J9.2, J10.2, J11.2, TP5.1, U1.2 (GND), U2.2 (GND), U3.3 (GND), U3.5 (GND), U3.21 (GND), Y1.2, Y1.4
unnamed: A1.3 (A2), J3.1
unnamed: A1.4 (A1), J3.2
unnamed: A1.5 (B1), J3.3
unnamed: A1.6 (B2), J3.4
unnamed: A2.3 (A2), J4.1
unnamed: A2.4 (A1), J4.2
unnamed: A2.5 (B1), J4.3
unnamed: A2.6 (B2), J4.4
unnamed: A3.3 (A2), J5.1
unnamed: A3.4 (A1), J5.2
unnamed: A3.5 (B1), J5.3
unnamed: A3.6 (B2), J5.4
unnamed: A4.3 (A2), J6.1
unnamed: A4.4 (A1), J6.2
unnamed: A4.5 (B1), J6.3
unnamed: A4.6 (B2), J6.4
unnamed: C9.1, U3.20 (AREF)
unnamed: D1.2 (A), R2.1

Notes on the sheet:
UART level shifters
Bluetooth module
+5V power supply
+3.3V power supply
Programming interface
Test points
Crystal
ATMega 328P
Status LED
Stepper motor drivers
Reset
LED Lights

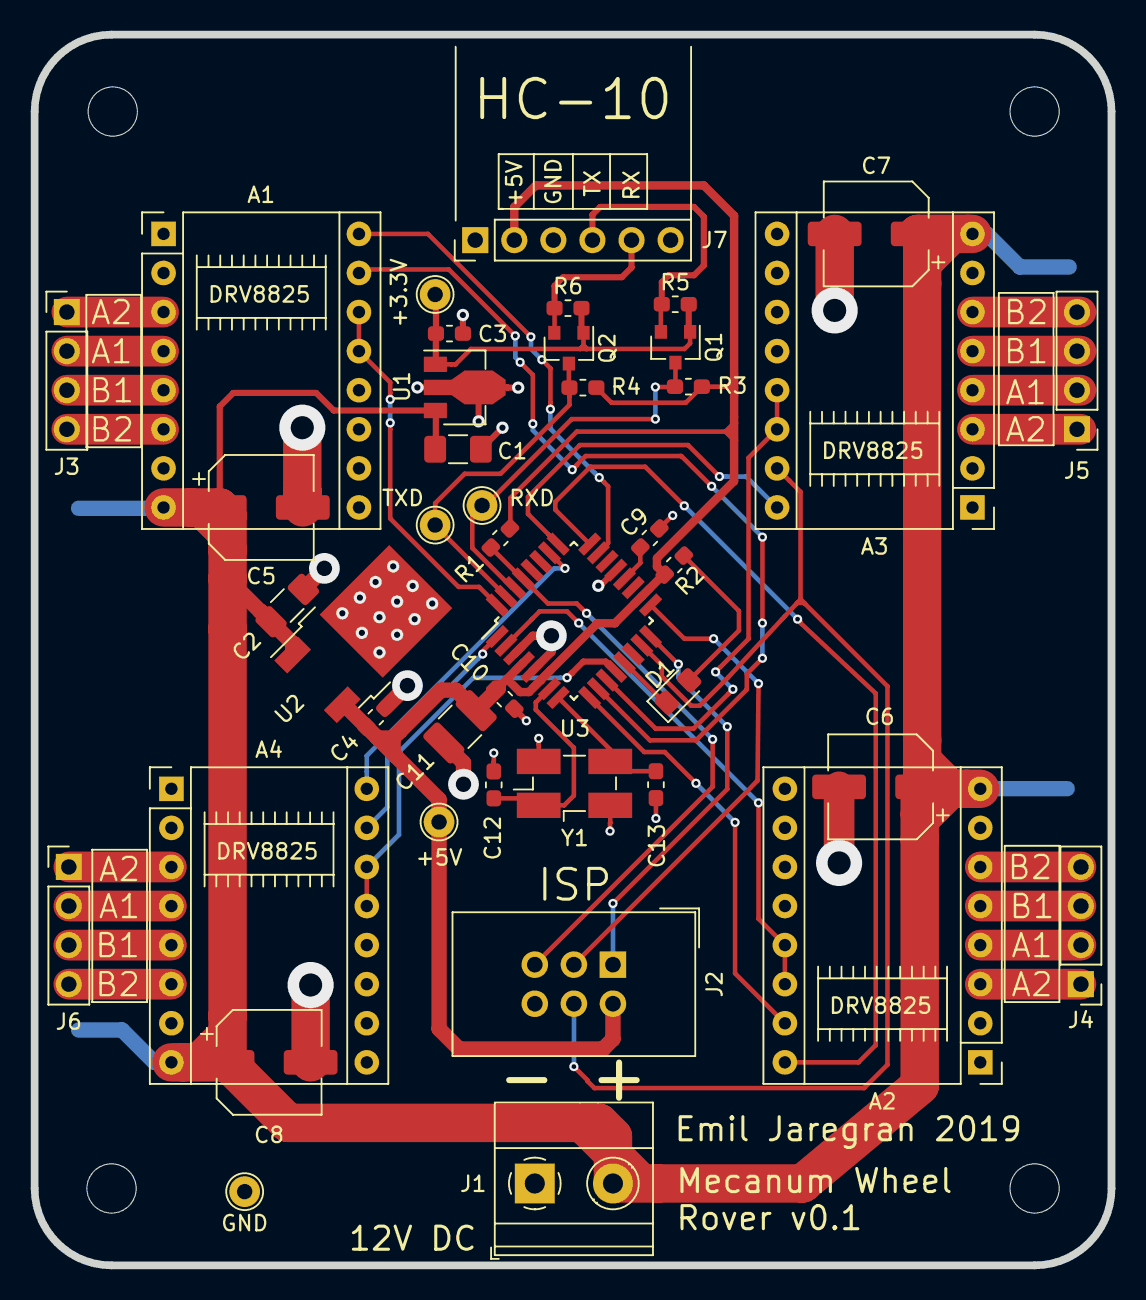
[picture p38: board rover-pcb.kicad_pcb from above]

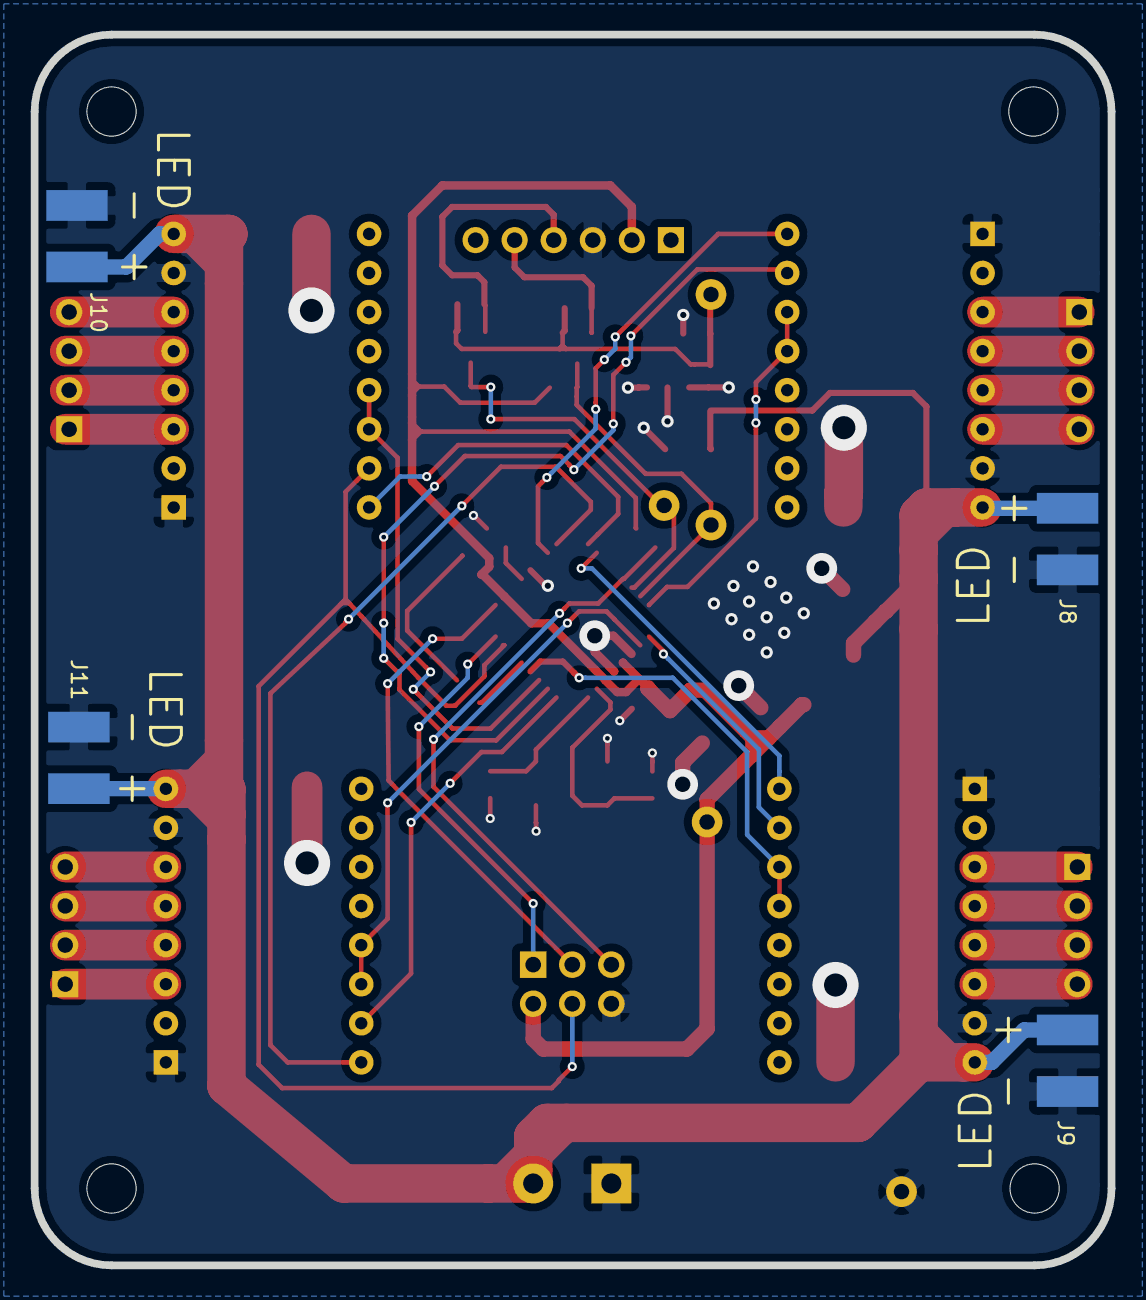
[picture p39: board rover-pcb.kicad_pcb from below]

Board: 2 copper layers, 70.0 x 80.0 mm, 46 parts (4 on the bottom side), 44 nets.
