emiljaregran/mecanum-wheel-rover/rover-firmware/stepper.h

#ifndef STEPPER_H
#define STEPPER_H

#define STEPPER_1_DIR       PORTC0
#define STEPPER_1_EN        PORTD2
#define STEPPER_1_STEP      PORTD6

#define STEPPER_2_DIR       PORTC1
#define STEPPER_2_EN        PORTD4
#define STEPPER_2_STEP      PORTD5

#define STEPPER_3_DIR       PORTC2
#define STEPPER_3_EN        PORTD7
#define STEPPER_3_STEP      PORTB3

#define STEPPER_4_DIR       PORTC3
#define STEPPER_4_EN        PORTB0
#define STEPPER_4_STEP      PORTD3

#define STEPPER_STOP        0
#define STEPPER_MOVE        1
#define STEPPER_FORWARD     0
#define STEPPER_BACKWARD    1

typedef struct
{
    uint8_t stepper_1_fast : 1;
    uint8_t stepper_1_slow : 1;
    uint8_t stepper_2_fast : 1;
    uint8_t stepper_2_slow : 1;
    uint8_t stepper_3_fast : 1;
    uint8_t stepper_3_slow : 1;
    uint8_t stepper_4_fast : 1;
    uint8_t stepper_4_slow : 1;
} stepper_speed_t;

extern stepper_speed_t stepper_speed;

void steppers_init(void);
void stepper_set_direction(const uint8_t stepper, const uint8_t direction);
void stepper_stop_all(void);

#endif // STEPPER_H
