emiljaregran/mecanum-wheel-rover/rover-firmware/uart.c

#include <avr/interrupt.h>
#include <avr/io.h>

#include <stdio.h>

#include "gpio.h"
#include "rover.h"
#include "timer.h"
#include "uart.h"

static volatile uint8_t buffer[BUFFER_SIZE];
static volatile uint8_t buffer_index = 0;
static FILE uart_stdout = FDEV_SETUP_STREAM(uart_putchar, NULL, _FDEV_SETUP_WRITE);

ISR(USART_RX_vect)
{
    if (buffer_index > (BUFFER_SIZE - 1))
    {
        buffer_index = 0;
    }

    buffer[buffer_index++] = UDR0;
}

void uart_init(joystick_t * const joystick)
{
    joystick->x = 0;
    joystick->y = 0;
    joystick->z = 0;

    UBRR0H = (unsigned char) (UBRR >> 8);
    UBRR0L = (unsigned char) (UBRR);
    UCSR0A = 0;
    UCSR0B = ((1 << TXEN0) | (1 << RXEN0) | (1 << RXCIE0));
    UCSR0C = ((1 << UCSZ01) | (1 << UCSZ00));

    stdout = &uart_stdout;
}

void uart_read_struct(uint8_t * p_joystick, size_t data_length)
{
    if (buffer_index >= data_length)
    {
        for (uint8_t byte = 0; byte < data_length; byte++)
        {
           *(p_joystick++) = buffer[byte];
        }

        buffer_index = 0;
        timer_stop_movement = REMOTE_TIMEOUT;
        led_on();
    }
}

int uart_putchar(char chr, FILE * stream)
{
    if ('\n' == chr)
    {
        uart_putchar('\r', stream);
    }
    while (!(UCSR0A & (1 << UDRE0)))
    {
    }

    UDR0 = chr;
    return 0;
}
