emiljaregran/mecanum-wheel-rover/rover-firmware/gpio.c

#include <avr/io.h>

#include "gpio.h"

void gpio_init(void)
{
    DDRB |= (1 << DDB1);
    led_off();
}

void led_blink(void)
{
    PINB |= (1 << PINB1);
}

void led_on(void)
{
    PORTB &= ~(1 << PORTB1);
}

void led_off(void)
{
    PORTB |= (1 << PORTB1);
}
