emiljaregran/mecanum-wheel-rover/joystick-firmware/serial.c

#include <avr/io.h>

#include <stdio.h>

#include "serial.h"

static FILE uart_stdout = FDEV_SETUP_STREAM(uart_putchar, NULL, _FDEV_SETUP_WRITE);

void uart_init(void)
{
    UBRR0H = (unsigned char)(UBRR >> 8);
    UBRR0L = (unsigned char)(UBRR);
    UCSR0A = 0;
    UCSR0B = (1 << TXEN0 | 1 << RXEN0);
    UCSR0C = (1 << UCSZ01 | 1 << UCSZ00);

    stdout = &uart_stdout;
}

void uart_putstruct(const uint8_t * p_start, uint8_t length)
{
    for (uint8_t byte = 0; byte < length; byte++)
    {
        while (!(UCSR0A & (1 << UDRE0)))
        {
        }

        UDR0 = p_start[byte];
    }
}

int uart_putchar(char chr, FILE * stream)
{
    if ('\n' == chr)
    {
        uart_putchar('\r', stream);
    }
    while (!(UCSR0A & (1 << UDRE0)))
    {
    }

    UDR0 = chr;
    return 0;
}

char uart_getchar(void)
{
    while (!(UCSR0A & (1 << RXC0)))
    {
    }

    return UDR0;
}
