emiljaregran/mecanum-wheel-rover/(commit log)

2019-09-30 Adding schematic for Rover PCB.
    [rover-pcb.kicad_pcb, rover-pcb.sch]
2019-09-30 Adding Rover PCB layout.
    [rover-pcb.sch]
2019-10-01 Adding pads for external LEDs.
    [rover-pcb.kicad_pcb, rover-pcb.sch]
2019-10-01 Adding Joystick PCB.
    [joystick-pcb.kicad_pcb, joystick-pcb.sch, rover-pcb.kicad_pcb]
2019-10-08 Adding CAD files.
    [M2x4_Countersunk_Screw.FCStd, M3-Nyloc-Nut.FCStd, M3x12-Buttonhead-Screw.FCStd, M3x6-Grub-Screw.FCStd, M3x8-Countersunk-Screw.FCStd, M4-Nyloc-Nut.FCStd, M4-Washer.FCStd, M4x10-Countersunk-Screw.FCStd]
2019-10-08 Set LED to OFF at start up.
2019-10-09 One wheel drive test-rover.
2019-10-11 Implemented acceleration and de-acceleration.
2019-10-12 Adding fan mount and refactor rover movement.
2019-10-12 Implementing kill switch.
2019-10-12 Implementing status LED and bugfix for ENABLE-pin.
    [main.c, rover.c, stepper.c, uart.c, uart.h]
2019-10-12 Adding CAD model for fan mount.
    [fan_mount.FCStd, fan_mount.stl]
2019-10-14 Fixed rover turned wrong directing driving north.
    [rover.c]
